chipsalliance/Cores-VeeR-EH2/docs/source/index.md

# {{project}}

```{toctree}
:maxdepth: 2
:numbered:

intro
overview
memory-map
error-protection
multi-threading
timers
power
interrupts
performance
cache
debugging
core-control
adaptations
csrs
interrupt-priority
clocks
complex-ports
build-args
tests
errata
```
