chipsalliance/Cores-VeeR-EH2/(threads)

Thread 10 (2020-10-10):

ICCM Only Mode (How does ICCM talks to External Memory)

HamzaShabbir517, 2020-10-10:
ICCM is in the core complex so in the ICCM Only Mode how are the instruction are loaded into ICCM from the External Memory.
In the test bench there is a task which pre-loads the ICCM, there are few issues with that
1) The first address in the PC is always zero so you never read the instruction from the ICCM.
2) As the address checking range from ICCM always failed so the instruction is always read from the External Memory.
3) Is there is any connectivity between the ICCM and the External Memory to load instruction from External Memory to ICCM?

agrobman, 2020-10-10:
Hi,

1) the ICCM base address is a build parameter and can be set to any value with swerv.config script.
2) CPU reset vector is the CPU complex input and can be driven by an SOC (or Demo TB) to anything. (DemoTB drives it to 0, but this can be easily changed locally if needed)
3) the  ICCM is designed as RAM. it need to be preloaded with application code ( unless redesigned as ROM or flash). Such preload can be done with external master via DMA port, or by the CPU itself if the SOC provides data path from LSU bus to DMA bus. ( One of the provided tests uses the LSU-DMA bridge).
4) ICCM can be preloaded with debugger via abstract memory commands. (via JTAG interface with openOCD driver)
5) Demo TB CCM preload mechanism is artificial and only works with verilog simulators. It is here to speed up simulations and demo purposes. This preloader can't be used with silicon or FPGA.

HamzaShabbir517, 2020-10-11:
As per basic knowledge. If the ICCM is not pre-loaded so during the execution if the instruction is not found so it will read the instruction from the external memory as we do in the cache. As  if there is a miss in cache so than it reads the instruction from memory.
As in Swerv core you have differrnt AXI4 streams for IFU, LSU, DMA and SB so to load instruction into ICCM why the core is using LSU DMA bridge rather than IFU AXI4 stream.

aprnath, 2020-10-11:
The ICCM is not a cache, and does not get loaded on fetch. It is an on-board memory, and only can be loaded via the DMA port, or debugger uploads.
If you set up the ICCM to be located at the reset vector, then you must load the ICCM via the debugger prior to releasing the core from reset. Otherwise the core will spin endlessly on illegal instruction execution fetching uninitialized garbage from the ICCM. I.e - core will not go fetch from external memory if the fetch address falls inside the ICCM region.

In general you need need a mechanism to load programs into the ICCM. Using the DMA port is the only way to do this without involving the debugger. You will need to have an external RAM/ROM that will have the boot-loader code, and either use the DMA port via an external DMA master, or via the bridge. The bridge is a simple filter/redirector/mux for load/stores that match the ICCM address range to reflect back via the DMA port. This allows you to copy programs from external memory into the ICCM. But the copy code itself must be done executing from external memory, or via code in ICCM loaded via the debugger.

Yes, somewhat convoluted :-(

Closed 2020-10-18.

Thread 15 (2021-06-23):

Cores-SweRV-EH2 Lint error

JLstore, 2021-06-23:
I use the **VC static** tools to check the code, and find the following Error.
Code version 1.4

 Tag              : UndrivenInTerm-ML
  Description      : Detected undriven input terminal [DesignObjSignal]
  Violation        : Lint:60
  Goal             : lint_rtl
  Module           : eh2_pic_ctrl
  FileName         : /ip/eh2/eh2_pic_ctrl.sv
  LineNumber       : 654
  Statement        :  assign picm_rd_data_in[31:0] = ({32{intpend_reg_read      }} &   intpend_rd_out                                                    ) |
  DesignObjSignal  : x_ecuss/rvtop/swerv/pic_ctrl_inst/mask[3:0]
  String1          :

 W123  (17 errors/0 waived)
  -----------------------------------------------------------------------------
  Tag           : W123
  Description   : Variable '[VariableName]'[ExprSize] read but never set.[Hierarchy: '[HIERARCHY]']
  Violation     : Lint:760
  Goal          : lint_rtl
  Module        : eh2_ifu_mem_ctl_thr
  FileName      : /ip/eh2/ifu/eh2_ifu_mem_ctl.sv
  LineNumber    : 2111
  Statement     :   assign ic_byp_data_only_pre_new[79:0] =  ({80{~ifu_fetch_addr_int_f2[2] & ~mb_idle}} &   {ic_miss_buff_data[byp_fetch_index_inc_0][15:0],ic_miss_buff_data[byp_fetch_index_1][31:0]     , ic_miss_buff_data[byp_fetch_index_0][31:0]}) |
  VariableName  : byp_fetch_index_inc_1
  ExprSize      :
  HIERARCHY     : rvtop/swerv/ifu/mem_ctl/THREADS[0].ifu_mem_ctl_thr_inst
  -----------------------------------------------------------------------------
  Tag           : W123
  Description   : Variable '[VariableName]'[ExprSize] read but never set.[Hierarchy: '[HIERARCHY]']
  Violation     : Lint:759
  Goal          : lint_rtl
  Module        : eh2_ifu_mem_ctl_thr
  FileName      : /ip/eh2/ifu/eh2_ifu_mem_ctl.sv
  LineNumber    : 2111
  Statement     :   assign ic_byp_data_only_pre_new[79:0] =  ({80{~ifu_fetch_addr_int_f2[2] & ~mb_idle}} &   {ic_miss_buff_data[byp_fetch_index_inc_0][15:0],ic_miss_buff_data[byp_fetch_index_1][31:0]     , ic_miss_buff_data[byp_fetch_index_0][31:0]}) |
  VariableName  : byp_fetch_index_inc_0
  ExprSize      :
  HIERARCHY     : rvtop/swerv/ifu/mem_ctl/THREADS[0].ifu_mem_ctl_thr_inst
  -----------------------------------------------------------------------------
  Tag           : W123
  Description   : Variable '[VariableName]'[ExprSize] read but never set.[Hierarchy: '[HIERARCHY]']
  Violation     : Lint:667
  Goal          : lint_rtl
  Module        : eh2_ifu_bp_ctl
  FileName      : /ip/eh2/ifu/eh2_ifu_bp_ctl.sv
  LineNumber    : 1710
  Statement     :         wire[3:0] wr_sel = {
  VariableName  : bht_wr_addr1
  ExprSize      :
  HIERARCHY     : rvtop/swerv/ifu/bp
  -----------------------------------------------------------------------------
  Tag           : W123
  Description   : Variable '[VariableName]'[ExprSize] read but never set.[Hierarchy: '[HIERARCHY]']
  Violation     : Lint:757
  Goal          : lint_rtl
  Module        : eh2_ifu_mem_ctl_thr
  FileName      : /ip/eh2/ifu/eh2_ifu_mem_ctl.sv
  LineNumber    : 2111
  Statement     :   assign ic_byp_data_only_pre_new[79:0] =  ({80{~ifu_fetch_addr_int_f2[2] & ~mb_idle}} &   {ic_miss_buff_data[byp_fetch_index_inc_0][15:0],ic_miss_buff_data[byp_fetch_index_1][31:0]     , ic_miss_buff_data[byp_fetch_index_0][31:0]}) |
  VariableName  : byp_fetch_index_0
  ExprSize      :
  HIERARCHY     : rvtop/swerv/ifu/mem_ctl/THREADS[0].ifu_mem_ctl_thr_inst
  -----------------------------------------------------------------------------
  Tag           : W123
  Description   : Variable '[VariableName]'[ExprSize] read but never set.[Hierarchy: '[HIERARCHY]']
  Violation     : Lint:669
  Goal          : lint_rtl
  Module        : eh2_ifu_bp_ctl
  FileName      : /ip/eh2/ifu/eh2_ifu_bp_ctl.sv
  LineNumber    : 1710
  Statement     :         wire[3:0] wr_sel = {
  VariableName  : bht_wr_addr3
  ExprSize      :
  HIERARCHY     : rvtop/swerv/ifu/bp
  -----------------------------------------------------------------------------
  Tag           : W123
  Description   : Variable '[VariableName]'[ExprSize] read but never set.[Hierarchy: '[HIERARCHY]']
  Violation     : Lint:658
  Goal          : lint_rtl
  Module        : eh2_ifu
  FileName      : /ip/eh2/ifu/eh2_ifu.sv
  LineNumber    : 590
  Statement     :       assign ifu_i1_bp_index [pt.NUM_THREADS-1:0] =  i1_bp_index[pt.NUM_THREADS-1:0];
  VariableName  : i1_bp_index
  ExprSize      : (1 bits)
  HIERARCHY     : rvtop/swerv/ifu
  -----------------------------------------------------------------------------
  Tag           : W123
  Description   : Variable '[VariableName]'[ExprSize] read but never set.[Hierarchy: '[HIERARCHY]']
  Violation     : Lint:660
  Goal          : lint_rtl
  Module        : eh2_ifu
  FileName      : /ip/eh2/ifu/eh2_ifu.sv
  LineNumber    : 586
  Statement     :       assign ifu_i0_bp_index [pt.NUM_THREADS-1:0] =  i0_bp_index[pt.NUM_THREADS-1:0];
  VariableName  : i0_bp_index
  ExprSize      : (1 bits)
  HIERARCHY     : rvtop/swerv/ifu
  -----------------------------------------------------------------------------
  Tag           : W123
  Description   : Variable '[VariableName]'[ExprSize] read but never set.[Hierarchy: '[HIERARCHY]']
  Violation     : Lint:1016
  Goal          : lint_rtl
  Module        : eh2_dec_csr
  FileName      : /ip/eh2/dec/eh2_dec_csr.sv
  LineNumber    : 607
  Statement     :    assign tlu_csr_pkt_d.valid_only = valid_only;
  VariableName  : valid_only
  ExprSize      :
  HIERARCHY     : rvtop/swerv/dec/tlu/i0_csr_decoder
  -----------------------------------------------------------------------------
  Tag           : W123
  Description   : Variable '[VariableName]'[ExprSize] read but never set.[Hierarchy: '[HIERARCHY]']
  Violation     : Lint:2017
  Goal          : lint_rtl
  Module        : eh2_pic_ctrl
  FileName      : /ip/eh2/eh2_pic_ctrl.sv
  LineNumber    : 654
  Statement     :  assign picm_rd_data_in[31:0] = ({32{intpend_reg_read      }} &   intpend_rd_out                                                    ) |
  VariableName  : mask[3:0]
  ExprSize      :
  HIERARCHY     : rvtop/swerv/pic_ctrl_inst
  -----------------------------------------------------------------------------
  Tag           : W123
  Description   : Variable '[VariableName]'[ExprSize] read but never set.[Hierarchy: '[HIERARCHY]']
  Violation     : Lint:779
  Goal          : lint_rtl
  Module        : eh2_ifu_aln_ctl
  FileName      : /ip/eh2/ifu/eh2_ifu_aln_ctl.sv
  LineNumber    : 1061
  Statement     :    assign i1_bp_index[pt.BTB_ADDR_HI:pt.BTB_ADDR_LO] = (i1_shift) ? i1_bpindex : '0;
  VariableName  : i1_bpindex
  ExprSize      :
  HIERARCHY     : rvtop/swerv/ifu/aln[0].aln
  -----------------------------------------------------------------------------
  Tag           : W123
  Description   : Variable '[VariableName]'[ExprSize] read but never set.[Hierarchy: '[HIERARCHY]']
  Violation     : Lint:778
  Goal          : lint_rtl
  Module        : eh2_ifu_aln_ctl
  FileName      : /ip/eh2/ifu/eh2_ifu_aln_ctl.sv
  LineNumber    : 1056
  Statement     :    assign i0_bp_index[pt.BTB_ADDR_HI:pt.BTB_ADDR_LO] = (i0_shift) ? i0_bpindex : '0;
  VariableName  : i0_bpindex
  ExprSize      :
  HIERARCHY     : rvtop/swerv/ifu/aln[0].aln
  -----------------------------------------------------------------------------
  Tag           : W123
  Description   : Variable '[VariableName]'[ExprSize] read but never set.[Hierarchy: '[HIERARCHY]']
  Violation     : Lint:2166
  Goal          : lint_rtl
  Module        : eh2_ifu_iccm_mem
  FileName      : /ip/eh2/ifu/eh2_ifu_iccm_mem.sv
  LineNumber    : 667
  Statement     :    assign iccm_rd_data_pre[95:0] = {iccm_bank_dout_fn[iccm_rd_addr_hi_q][31:0], iccm_bank_dout_fn[iccm_rd_addr_md_q][31:0], iccm_bank_dout_fn[iccm_rd_addr_lo_q[pt.ICCM_BANK_HI:2]][31:0]};
  VariableName  : iccm_rd_addr_md_q
  ExprSize      :
  HIERARCHY     : rvtop/mem/iccm.iccm
  -----------------------------------------------------------------------------
  Tag           : W123
  Description   : Variable '[VariableName]'[ExprSize] read but never set.[Hierarchy: '[HIERARCHY]']
  Violation     : Lint:668
  Goal          : lint_rtl
  Module        : eh2_ifu_bp_ctl
  FileName      : /ip/eh2/ifu/eh2_ifu_bp_ctl.sv
  LineNumber    : 1710
  Statement     :         wire[3:0] wr_sel = {
  VariableName  : bht_wr_addr2
  ExprSize      :
  HIERARCHY     : rvtop/swerv/ifu/bp
  -----------------------------------------------------------------------------
  Tag           : W123
  Description   : Variable '[VariableName]'[ExprSize] read but never set.[Hierarchy: '[HIERARCHY]']
  Violation     : Lint:666
  Goal          : lint_rtl
  Module        : eh2_ifu_bp_ctl
  FileName      : /ip/eh2/ifu/eh2_ifu_bp_ctl.sv
  LineNumber    : 1710
  Statement     :         wire[3:0] wr_sel = {
  VariableName  : bht_wr_addr0
  ExprSize      :
  HIERARCHY     : rvtop/swerv/ifu/bp
  -----------------------------------------------------------------------------
  Tag           : W123
  Description   : Variable '[VariableName]'[ExprSize] read but never set.[Hierarchy: '[HIERARCHY]']
  Violation     : Lint:2077
  Goal          : lint_rtl
  Module        : EH2_IC_TAG
  FileName      : /ip/eh2/ifu/eh2_ifu_ic_mem.sv
  LineNumber    : 1373
  Statement     :                  `EH2_IC_TAG_PACKED_SRAM(64,104)
  VariableName  : ic_rw_addr_q
  ExprSize      :
  HIERARCHY     : rvtop/mem/icache.icm/ic_tag_inst
  -----------------------------------------------------------------------------
  Tag           : W123
  Description   : Variable '[VariableName]'[ExprSize] read but never set.[Hierarchy: '[HIERARCHY]']
  Violation     : Lint:2165
  Goal          : lint_rtl
  Module        : eh2_ifu_iccm_mem
  FileName      : /ip/eh2/ifu/eh2_ifu_iccm_mem.sv
  LineNumber    : 667
  Statement     :    assign iccm_rd_data_pre[95:0] = {iccm_bank_dout_fn[iccm_rd_addr_hi_q][31:0], iccm_bank_dout_fn[iccm_rd_addr_md_q][31:0], iccm_bank_dout_fn[iccm_rd_addr_lo_q[pt.ICCM_BANK_HI:2]][31:0]};
  VariableName  : iccm_rd_addr_hi_q
  ExprSize      :
  HIERARCHY     : rvtop/mem/iccm.iccm
  -----------------------------------------------------------------------------
  Tag           : W123
  Description   : Variable '[VariableName]'[ExprSize] read but never set.[Hierarchy: '[HIERARCHY]']
  Violation     : Lint:758
  Goal          : lint_rtl
  Module        : eh2_ifu_mem_ctl_thr
  FileName      : /ip/eh2/ifu/eh2_ifu_mem_ctl.sv
  LineNumber    : 2111
  Statement     :   assign ic_byp_data_only_pre_new[79:0] =  ({80{~ifu_fetch_addr_int_f2[2] & ~mb_idle}} &   {ic_miss_buff_data[byp_fetch_index_inc_0][15:0],ic_miss_buff_data[byp_fetch_index_1][31:0]     , ic_miss_buff_data[byp_fetch_index_0][31:0]}) |
  VariableName  : byp_fetch_index_1
  ExprSize      :
  HIERARCHY     : rvtop/swerv/ifu/mem_ctl/THREADS[0].ifu_mem_ctl_thr_inst

agrobman, 2021-06-23:
Based on designers response, these warnings are "bogus".  We have no idea what this lint tool is. Please, consult with the tool vendor why the tool flags these structures.

JLstore, 2021-06-24:
@agrobman
The above report is errors not warnings.
 For example , I check that the _**mask**_ signal in the /ip/eh2/eh2_pic_ctrl.sv is not drived.
 I guss the errors labeled "Description : Variable '[VariableName]'[ExprSize] read but never set.[Hierarchy: '[HIERARCHY]']"  are the same reason.
Because I find the _**valid_only**_ signal in the dec/eh2_dec_csr.sv is not drived, either.
Please designers check the above errors again.
About the lint tool. https://www.synopsys.com/verification/static-and-formal-verification/vc-formal.html

agrobman, 2021-06-24:
the mask signal is driven in pic_map_auto.h (generated) file.

valid_only is not used ...

JLstore, 2021-06-25:
@agrobman
The pic_map_auto.h is empty. What do I miss in the configuration(swerv.config file)
valid_only is not used, which means that the following signals belong to **the above log** are not used or driven in pic_map_auto.h?
Signal:
byp_fetch_index_inc_1
bht_wr_addr1
bht_wr_addr3
byp_fetch_index_inc_0
bht_wr_addr2
byp_fetch_index_0
i1_bp_index
i0_bp_index
i1_bpindex
bht_wr_addr0
i0_bpindex
iccm_rd_addr_md_q
ic_rw_addr_q
iccm_rd_addr_hi_q
byp_fetch_index_1

agrobman, 2021-06-25:
just ran
make -f $RV_ROOT/tools/Makefile
snanpshots/default/pic_map_auto.h :

```
// mask[3:0] = { 4'b1000 - 30b mask,4'b0100 - 31b mask, 4'b0010 - 28b mask, 4'b0001 - 32b mask }
always_comb begin
  case (address[14:0])
    15'b011000000000000 : mask[3:0] = 4'b0100;
    15'b110000000000100 : mask[3:0] = 4'b0001;
    15'b110000000001000 : mask[3:0] = 4'b0001;
    15'b110000000001100 : mask[3:0] = 4'b0001;
    15'b110000000010000 : mask[3:0] = 4'b0001;
    15'b110000000010100 : mask[3:0] = 4'b0001;
    15'b110000000011000 : mask[3:0] = 4'b0001;
    15'b110000000011100 : mask[3:0] = 4'b0001;
...
    15'b000000111111100 : mask[3:0] = 4'b0010;
    default           : mask[3:0] = 4'b0001;
  endcase
end

```
try to see if you can run:
`$RV_ROOT/tools/picmap -t 20 -n 1`

for ic_rw_addr_q  :

```
grep -r ic_rw_addr_q design
design/ifu/eh2_ifu_ic_mem.sv:   logic [pt.ICACHE_INDEX_HI:1]                                                   ic_rw_addr_q;
..
design/ifu/eh2_ifu_ic_mem.sv:  assign ic_rw_addr_q[pt.ICACHE_INDEX_HI:1] = (ic_debug_rd_en | ic_debug_wr_en) ?
```

```
i1_bp_index
design/ifu/eh2_ifu_aln_ctl.sv:   output logic [pt.BTB_ADDR_HI:pt.BTB_ADDR_LO]  i1_bp_index,  // BP index
design/ifu/eh2_ifu_aln_ctl.sv:   assign i1_bp_index[pt.BTB_ADDR_HI:pt.BTB_ADDR_LO] = (i1_shift) ? i1_bpindex : '0;
```

JLstore, 2021-06-28:
@agrobman
Thanks !
I just run

_make -f $RV_ROOT/tools/Makefile
$RV_ROOT/tools/picmap -t 20 -n 1
./swerv.config ..._

then I get my configurtion with mask signal (in pic_map_auto.h ).

About ic_rw_addr_q, i1_bp_index ... signals and so on.
I can grep them in the design, also.
I mean  how I can handle these lint error ?  Can I just ignore them ?

JLstore, 2021-06-29:
@agrobman
I check the following signals, find those signals are not defined from 0 bit, which I guss the lint tools regard them as error.
Thank for your help.

Signal:
byp_fetch_index_inc_1
bht_wr_addr1
bht_wr_addr3
byp_fetch_index_inc_0
bht_wr_addr2
byp_fetch_index_0
i1_bp_index
i0_bp_index
i1_bpindex
bht_wr_addr0
i0_bpindex
iccm_rd_addr_md_q
ic_rw_addr_q
iccm_rd_addr_hi_q
byp_fetch_index_1

Closed 2021-06-29.

Thread 18 (2021-07-22):

Core Design validation/verification

SyoAnd, 2021-07-22:
Hello
I see in the documentation that this core has been validated to compliance with RISC-V spec.
But it is not stated to what level the core is checked.
Is it a simple compliance check, validation, or a full verification?

I want to make an addition to the core, but in doing so, I want to make sure that I don't break the execution of the core in any way.
How would I do this the best way?
I have looked at several tools for validation, RISCOF being the latest one. Will I be able to use it for validation of this design?

aprnath, 2021-07-22:
Hi @SyoAnd,

It is full verification, per the spec.

However, this verification environment is not currently part of this opensource effort. So you would need to first plan, build and execute a full verification suite, in case you wish to make changes/additions :-( .
Or you could possibly use some incremental equivalency checking mechanisms to incrementally check your localized changes.

Thread 19 (2021-09-08):

multi thread cache miss question

S-Nomii, 2021-09-08:
Hi, I am studying how EH2 handle cache miss, and i encountered a problem about the miss state machine. How does the DUPL_MISS_WAIT state work?

What I currently understand is :
When thread 1 miss on an index on which thread 0 is currently handling an elder miss, thread 1 use this state to lock its miss handler. Thread 1 will release the lock, refetch the missing line and start handling this latter miss after thread 0 is done.

 I dont know if I understand this state correctly. If I'm right, what is the purpose of this processing sequence? Is it for LRU update order.

iknowzxc, 2023-03-17:
maybe MSHR, DUPL is duplicated

Thread 20 (2021-09-21):

understanding I-Cache

vignajeth, 2021-09-21:
Hi,
  I am trying to understand the RTL that generates the I-Cache. I am currently running the default configuration that makes the core run on single thread.
I find the parameters in eh2_param.vh as
```
ICACHE_BANKS_WAY       : 7'h02
ICACHE_NUM_WAYS        : 7'h04
```
based on this I am interpreting it as two-way set associative cache as BANKS means Blocks and NUM_WAYS means Number_of_Sets in a cache
I am focusing only on the Packed I-Cache and ECC enabled, However I am confused with this line of code
https://github.com/chipsalliance/Cores-SweRV-EH2/blob/a95fdb81ea6dc19239cfe2953ef00710a6f1cf2a/design/ifu/eh2_ifu_ic_mem.sv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
because the cache data should be only in one of the bank, but here I find both the banks data merged into a array and is later used

please let me know if my understanding is wrong or if you need few more details about my doubt

agrobman, 2021-09-21:
ICACHE_NUM_WAYS - defines cache associativity , meaning in your case the cache has 4 ways.
BANKS_WAY - number data memory arrays per way, i.e. 2 - it's fixed design parameter, which can't be changed without RTL changes

vignajeth, 2021-09-22:
Okay, This means there is only 1 Set in I-Cache no matter the size of I-cache or whether it is two or four way associative, right ?

agrobman, 2021-09-22:
depends on what do you call 'Set'

Closed 2021-09-27.

Thread 23 (2021-10-05):

Working of Non-Blocking Loads

vignajeth, 2021-10-05:
Hi,
    When I run hello world assembly code, I notice that STDOUT data moves out of LSU through non-blocking loads.

I would like to know how the core decides that it can move the data through non-blocking load ports

I was unable to get much information about non-blocking loads from PRM, the PRM I think just has registers that can point out during non-blocking load bus errors.

```
        79 :      #20 0 00000042 00010217  tp=00010042 ; auipc   tp,0x10000
        80 :      #21 0 00000046 fbe20213  tp=00010000 ; addi    tp,tp,-66
        80 :      #22 0 0000004a 0000a821              ; c.j     0x62
        85 :      #23 0 00000062 00020283              ; lb      t0,0(tp) [00010000]
        87 :          0                    t0=0000002d ; nbL       <--------------------------------- Here
        93 :      #24 0 00000066 00518023              ; sb      t0,0(gp) [d0580000]
        93 :      #25 0 0000006a 00000205  tp=00010001 ; c.addi  tp,1
        94 :      #26 0 0000006c fe029be3              ; bne     t0,zero,0x62
        99 :      #27 0 00000062 00020283              ; lb      t0,0(tp) [00010001]
       101 :          0                    t0=0000002d ; nbL       <--------------------------------- Here
       107 :      #28 0 00000066 00518023              ; sb      t0,0(gp) [d0580000]
```

Thanks

aprnath, 2021-10-05:
Non-blocking loads are a micro-architectural feature for performance improvement. They are not SW or architecturally visible, hence not mentioned in detail in the Programmer's reference Manual.

All loads to external memory are treated as non-blocking. The core issues and commits them without waiting for data to be returned. However, it keeps track of register dependencies, and blocks subsequent instruction that consume the data from the load's destination register from being issued into the pipe until dependent loads return data. This allows a certain small "out-of-order"ness to the core to give a performance boost.

Closed 2021-12-09.

Thread 25 (2021-10-21):

understanding store_databypass_c1 and c2

vignajeth, 2021-10-21:
Hi,
   I am trying to understand how _store_data_bypass_c1_ and _store_data_bypass_c2_ signal helps in forwarding data.
I took a simple RAW hazard scenario as below and only one thread is executing this in order.
```
  lw X13, 23(X10);
  sw X13, 32(X11);
```
when the `sw` instruction is in decode stage the _store_data_bypass_c2_ should become high.
the LSU dc1 to dc3 stages for the two instruction should be like
```
LW LW LW
   SW SW
```
and from the code of lsu I can understand that when `sw` instruction is executed in lsu,  _store_data_dc2_ gets overwritten with _lsu_result_dc3_ data. which is basically forwarding `lw` data

but this is a best case scenario since the previous `lw` instruction should have obtained data in dc3 either through lsu_buffer or from a forwarding logic.

My question here is if the previous `lw`  data was not in buffer, it should take 5 or 6 CC to get data from the main memory, then this `sw` instruction should be stalled for few cycles, but i don't think this stall happens or there is some other way the core takes care of this situation.

it would be great if someone can help me fill my missing piece of insight.

vignajeth, 2021-11-05:
```  assign i1_load2_block_d = i1_dp.lsu & i0_dp.lsu;```
 👍

Closed 2021-11-05.

Thread 31 (2021-12-09):

understanding of axi_lsu_dma_bridge

vignajeth, 2021-12-09:
Hi,
   I notice that the module `axi_lsu_dma_bridge`  in testbench has one master (lsu) and two slaves ( s0 - main memory, s1 - dma).
   When I looked into the code I observed that when the master provided address falls into iccm address range,  the bridge directs the request to dma slave.

right now the TB directly dumps the data into dccm, iccm. but in real case scenario with the use of lw, sw instructions pointing to dccm address it is possible to write/read data from dccm.

However, to write data into iccm, the data should be moved through lsu and is written in iccm through dma using this bridge right ?
in case of read to iccm, the lsu read request is sent to dma slave , the dma slave will fetch data from iccm and give it to lsu right ?

In short, can i say that this bridge is used for reading/writing iccm ?

let me know if my understanding is write / wrong 😃

aprnath, 2021-12-09:
Yes, your understanding is correct. This bridge is an external splitter component that helps provide a loopback path to do load/stores to the ICCM via the DMA port. The ICCM would otherwise not be accessible other than via debugger or needing an external DMA master in the SOC.

vignajeth, 2021-12-10:
Thanks for your reply

Closed 2021-12-10.

Thread 32 (2021-12-13):

No improvement for Statistics

samfishman1, 2021-12-13:
Hi, I am currently trying to improve upon the base statistics generated when running the Coremark example.
I am running with the following command
` make -f $RV_ROOT/tools/Makefile $@ target=default TEST=cmark'

Where the $@ is a number of CONF_PARAM=-set=... commands that I have being set from another file. These params include changing the icache_size and dccm_size, basically all variables provided in order to try to change the coremark return values at all. So far though it seems as if there has been no change at all, is there another step that I am missing? I have not installed espresso, is this necessary?

vignajeth, 2021-12-14:
Hi,
    I notice a typo, it is CONF_PARAMS and this is the exact command i used in command line
     `make -f ./tools/Makefile clean irun debug=1 TEST=hello_world CONF_PARAMS=-set=build_axi4\ -set=load_to_use_plus1=1`
    I was able to see `LOAD_TO_USE_PLUS1      : 5'h01 ` which is 0 by default. So, i think there is some mistake in your Makefile.

samfishman1, 2021-12-14:
Hi,
I think I may have been unclear, the CONF_PARAMS is not the issue I am having. I am able to pass these values and they are set with the command line with no issue. The problem happens after the params have been set. When the test runs we see an output for it such as this:

> 2K performance run parameters for coremark.
CoreMark Size    : 666
Total ticks      : 457594
Total time (secs): 457
Iterat/Sec/MHz   : 2.18
Iterations       : 1
Compiler version : GCC11.1.0
Compiler flags   : -g -O3 -funroll-all-loops
Memory location  : STATIC
seedcrc          : 0xe9f5
[0]crclist       : 0xe714
[0]crcmatrix     : 0x1fd7
[0]crcstate      : 0x8e3a
[0]crcfinal      : 0xe714
Correct operation validated. See readme.txt for run and reporting rules.
TEST_PASSED
Finished hart0 : minstret = 300365, mcycle = 481320

And when I insert new CONF_PARAMS I would expect values such as minstret and mcycle to chane. BUT the issue I am having is that when I change the CONF_PARAMS there is no change in the output statistics between test runs.

I am deleting the program.hex between runs and the test is recompiling each time. Is there possibly another step or another link I have to set in order to force the tests statistics to change due to the CONF_PARAMS?

vignajeth, 2021-12-15:
What parameter you change matters. if you try comparing the cmark results with two different DCCM sizes, you will find that both of them give same values. This is because cmark does not use DCCM.

do you get the same results with the commands as below ?

Command: make -f ./tools/Makefile clean irun debug=1 TEST=cmark CONF_PARAMS=-set=build_axi4\ -set=lsu_stbuf_depth=8\ -set=lsu_num_nbload=8
>2K performance run parameters for coremark.
CoreMark Size    : 666
Total ticks      : 453314
Total time (secs): 453
Iterat/Sec/MHz   : 2.20
Iterations       : 1
Compiler version : GCC8.3.0
Compiler flags   : -g -O3 -funroll-all-loops
Memory location  : STATIC
seedcrc          : 0xe9f5
[0]crclist       : 0xe714
[0]crcmatrix     : 0x1fd7
[0]crcstate      : 0x8e3a
[0]crcfinal      : 0xe714
Correct operation validated. See readme.txt for run and reporting rules.
TEST_PASSED
Finished hart0 : minstret = 298128, mcycle = 478988

Command: make -f ./tools/Makefile clean irun debug=1 TEST=cmark CONF_PARAMS=-set=build_axi4\ -set=lsu_stbuf_depth=2\ -set=lsu_num_nbload=2
> 2K performance run parameters for coremark.
CoreMark Size    : 666
Total ticks      : 972823
Total time (secs): 972
Iterat/Sec/MHz   : 1.02
Iterations       : 1
Compiler version : GCC8.3.0
Compiler flags   : -g -O3 -funroll-all-loops
Memory location  : STATIC
seedcrc          : 0xe9f5
[0]crclist       : 0xe714
[0]crcmatrix     : 0x1fd7
[0]crcstate      : 0x8e3a
[0]crcfinal      : 0xe714
Correct operation validated. See readme.txt for run and reporting rules.
TEST_PASSED
Finished hart0 : minstret = 298123, mcycle = 1043357

samfishman1, 2021-12-15:
With these exact commands I am unable to run. I am unsure where the library for irun is, but I have been unable to find online where to download/how to install it so I had to remove this command. As well when I include the clean command in this the test is never executed, instead the directory is just cleaned of the previous test and then the run stops.
Even after removing these two commands I still am experiencing an error due to the lsu_stbuf flag due to a comparison error in the verilator.
Are there any packages you would recommend installing?
What environment are you running in? I am running on ubuntu20.04 on a bare metal/equinix c1.small.x86 remote server
Thank you!

agrobman, 2021-12-15:
use 'verilator' instead of 'irun' with make command or whatever system verilog  simulator you have of the supported by the project makefile (vcs, vlog etc)  (read README.md first, how to run simulations with this core)

Thread 33 (2021-12-19):

[Question] AXI4-ectomy

michael-etzkorn, 2021-12-19:
If I wanted to try removing the AXI4 bus interface and replace it with a different bus interface, would modifying `eh2_ifu_mem_ctl` and `eh2_lsu_bus_intf` be sufficient? I'm still tracing the code where `.*` is used, but I figure it should be possible to swap the cache's memory interface.

aprnath, 2022-01-04:
Yes, these are good places to start for the fetch and load/store bus. However, you will also need to touch  eh2_dma_ctrl.sv and eh2_dbg.sv for the DMA and debug bus interfaces.

michael-etzkorn, 2022-01-05:
Great! Appreciate the guidance 😄

Closed 2022-01-05.

Thread 39 (2022-07-06):

PreSync/PostSync in CSR Registers

vignajeth, 2022-07-06:
Hi,
   Can someone tell the difference between presync/postsync in CSR registers ? .  why such synchronization is required ?. At a very high level,  I can see these pre/post sync introduce stalls in pipe and the stall remains active until the pipeline is empty. But I can't figure out the difference between the them.

Thanks

Thread 40 (2023-02-07):

Repeated entry interrupt

luis-han255, 2023-02-07:
Hi，
When I trigger PIC interrupt，the value of **mcause** register is **0x2** and **mepc** register is **0x0**. I found that the general register **x1** has return address and then assigned it to mepc. Sometimes interruptions can end smoothly, Sometimes after exiting interrupt, it will enter the interrupt handler again, and x1 is 0. Of course, I have cleared the interrupt source.
Please give me some suggestions on this issue.

Thanks

Thread 42 (2024-06-05):

dhry_mt benchmark failed

chchenl, 2024-06-05:
Hi all,
I cannot successfully run dhry_mt program-- it always times out. But if I remark the last few 'printf' related to
floating point calculations(on performance numbers), the progarm can be successfully completed. But strange
enough, the cmark program can be successfully completed in spite of its having floating point calculations.

Does anyone have any ideas on this? My enviroment is : verilator 4.227, riscv toolchain compiled based on gcc 10.2.0
The command issued is: make -f $RV_ROOT/tools/Makefile verilator target=default_mt TEST=dhry_mt
