chipsalliance/Cores-VeeR-EH2/testbench/tb_top.sv

// SPDX-License-Identifier: Apache-2.0
// Copyright 2019,2020 Western Digital Corporation or its affiliates.
//
// Licensed under the Apache License, Version 2.0 (the "License");
// you may not use this file except in compliance with the License.
// You may obtain a copy of the License at
//
// http://www.apache.org/licenses/LICENSE-2.0
//
// Unless required by applicable law or agreed to in writing, software
// distributed under the License is distributed on an "AS IS" BASIS,
// WITHOUT WARRANTIES OR CONDITIONS OF ANY KIND, either express or implied.
// See the License for the specific language governing permissions and
// limitations under the License.
//
// this is testbench file

`ifdef VERILATOR
module tb_top (
    input bit                   core_clk,
    input bit [31:0]            mem_signature_begin,
    input bit [31:0]            mem_signature_end
);
`else
module tb_top;
    bit                         core_clk;
`endif
    logic                       rst_l;
    logic                       porst_l;
    logic                       nmi_int;

`ifndef VERILATOR
    bit          [31:0]         mem_signature_begin = 32'd0;
    bit          [31:0]         mem_signature_end   = 32'd0;
`endif

    logic        [`RV_XLEN-1:0] reset_vector;
    logic        [`RV_XLEN-1:0] nmi_vector;
    logic        [31:1]         jtag_id;

// AHB
    logic        [`RV_XLEN-1:0]         ic_haddr;
    logic        [2:0]                  ic_hburst;
    logic        [3:0]                  ic_hprot;
    logic        [2:0]                  ic_hsize;
    logic        [1:0]                  ic_htrans;
    logic                               ic_hwrite;
    logic        [`RV_BUS_WIDTH-1:0]    ic_hrdata;
    logic                               ic_hready;
    logic                               ic_hresp;

    logic        [`RV_XLEN-1:0]         lsu_haddr;
    logic        [2:0]                  lsu_hburst;
    logic        [3:0]                  lsu_hprot;
    logic        [2:0]                  lsu_hsize;
    logic        [1:0]                  lsu_htrans;
    logic                               lsu_hwrite;
    logic        [`RV_BUS_WIDTH-1:0]    lsu_hrdata;
    logic        [`RV_BUS_WIDTH-1:0]    lsu_hwdata;
    logic                               lsu_hready;
    logic                               lsu_hresp;

    logic [`RV_NUM_THREADS-1:0][`RV_XLEN*2-1:0] trace_rv_i_insn_ip;
    logic [`RV_NUM_THREADS-1:0][`RV_XLEN*2-1:0] trace_rv_i_address_ip;
    logic [`RV_NUM_THREADS-1:0][1:0]           trace_rv_i_valid_ip;
    logic [`RV_NUM_THREADS-1:0][1:0]           trace_rv_i_exception_ip;
    logic [`RV_NUM_THREADS-1:0][4:0]           trace_rv_i_ecause_ip;
    logic [`RV_NUM_THREADS-1:0][1:0]           trace_rv_i_interrupt_ip;
    logic [`RV_NUM_THREADS-1:0][`RV_XLEN*2-1:0] trace_rv_i_tval_ip;

    logic                       o_debug_mode_status;


    logic                       jtag_tdo;
    logic                       o_cpu_halt_ack;
    logic                       o_cpu_halt_status;
    logic                       o_cpu_run_ack;

    logic                       mailbox_write;

    logic [`RV_BUS_WIDTH-1:0]   lmem_hrdata;
    logic [`RV_BUS_WIDTH-1:0]   lmem_hwdata;
    logic                       lmem_hready;
    logic                       lmem_hresp;
    logic [`RV_XLEN-1:0]        lmem_haddr;
    logic [2:0]                 lmem_hburst;
    logic                       lmem_hmastlock;
    logic [3:0]                 lmem_hprot;
    logic [2:0]                 lmem_hsize;
    logic [1:0]                 lmem_htrans;
    logic                       lmem_hwrite;
    logic                       lmem_hsel;

    logic [`RV_BUS_WIDTH-1:0]   dma_hrdata;
    logic [`RV_BUS_WIDTH-1:0]   dma_hwdata;
    logic                       dma_hready;
    logic                       dma_hresp;
    logic [`RV_XLEN-1:0]        dma_haddr;
    logic [2:0]                 dma_hburst;
    logic                       dma_hmastlock;
    logic [3:0]                 dma_hprot;
    logic [2:0]                 dma_hsize;
    logic [1:0]                 dma_htrans;
    logic                       dma_hwrite;
    logic                       dma_hsel;

    logic                       mpc_debug_halt_req;
    logic                       mpc_debug_run_req;
    logic                       mpc_reset_run_req;
    logic                       mpc_debug_halt_ack;
    logic                       mpc_debug_run_ack;
    logic                       debug_brkpt_status;

    bit        [31:0]           cycleCnt;
    logic                       mailbox_data_val;

    int                         commit_count[2];

    logic [1:0]                 wb_valid;
    logic [1:0][4:0]            wb_dest;
    logic [1:0][`RV_XLEN-1:0]   wb_data;
    logic [1:0]                 wb_tid;

   //-------------------------- LSU AXI signals--------------------------
   // AXI Write Channels
    wire                            lsu_axi_awvalid;
    wire                            lsu_axi_awready;
    wire [`RV_LSU_BUS_TAG-1:0]      lsu_axi_awid;
    wire [`RV_XLEN-1:0]             lsu_axi_awaddr;
    wire [3:0]                      lsu_axi_awregion;
    wire [7:0]                      lsu_axi_awlen;
    wire [2:0]                      lsu_axi_awsize;
    wire [1:0]                      lsu_axi_awburst;
    wire                            lsu_axi_awlock;
    wire [3:0]                      lsu_axi_awcache;
    wire [2:0]                      lsu_axi_awprot;
    wire [3:0]                      lsu_axi_awqos;

    wire                            lsu_axi_wvalid;
    wire                            lsu_axi_wready;
    wire [`RV_BUS_WIDTH-1:0]        lsu_axi_wdata;
    wire [`RV_BUS_BYTES-1:0]        lsu_axi_wstrb;
    wire                            lsu_axi_wlast;

    wire                            lsu_axi_bvalid;
    wire                            lsu_axi_bready;
    wire [1:0]                      lsu_axi_bresp;
    wire [`RV_LSU_BUS_TAG-1:0]      lsu_axi_bid;

    // AXI Read Channels
    wire                            lsu_axi_arvalid;
    wire                            lsu_axi_arready;
    wire [`RV_LSU_BUS_TAG-1:0]      lsu_axi_arid;
    wire [`RV_XLEN-1:0]             lsu_axi_araddr;
    wire [3:0]                      lsu_axi_arregion;
    wire [7:0]                      lsu_axi_arlen;
    wire [2:0]                      lsu_axi_arsize;
    wire [1:0]                      lsu_axi_arburst;
    wire                            lsu_axi_arlock;
    wire [3:0]                      lsu_axi_arcache;
    wire [2:0]                      lsu_axi_arprot;
    wire [3:0]                      lsu_axi_arqos;

    wire                            lsu_axi_rvalid;
    wire                            lsu_axi_rready;
    wire [`RV_LSU_BUS_TAG-1:0]      lsu_axi_rid;
    wire [`RV_BUS_WIDTH-1:0]        lsu_axi_rdata;
    wire [1:0]                      lsu_axi_rresp;
    wire                            lsu_axi_rlast;

    //-------------------------- IFU AXI signals--------------------------
    // AXI Write Channels
    wire                            ifu_axi_awvalid;
    wire                            ifu_axi_awready;
    wire [`RV_IFU_BUS_TAG-1:0]      ifu_axi_awid;
    wire [`RV_XLEN-1:0]             ifu_axi_awaddr;
    wire [3:0]                      ifu_axi_awregion;
    wire [7:0]                      ifu_axi_awlen;
    wire [2:0]                      ifu_axi_awsize;
    wire [1:0]                      ifu_axi_awburst;
    wire                            ifu_axi_awlock;
    wire [3:0]                      ifu_axi_awcache;
    wire [2:0]                      ifu_axi_awprot;
    wire [3:0]                      ifu_axi_awqos;

    wire                            ifu_axi_wvalid;
    wire                            ifu_axi_wready;
    wire [63:0]                     ifu_axi_wdata;
    wire [7:0]                      ifu_axi_wstrb;
    wire                            ifu_axi_wlast;

    wire                            ifu_axi_bvalid;
    wire                            ifu_axi_bready;
    wire [1:0]                      ifu_axi_bresp;
    wire [`RV_IFU_BUS_TAG-1:0]      ifu_axi_bid;

    // AXI Read Channels
    wire                            ifu_axi_arvalid;
    wire                            ifu_axi_arready;
    wire [`RV_IFU_BUS_TAG-1:0]      ifu_axi_arid;
    wire [`RV_XLEN-1:0]             ifu_axi_araddr;
    wire [3:0]                      ifu_axi_arregion;
    wire [7:0]                      ifu_axi_arlen;
    wire [2:0]                      ifu_axi_arsize;
    wire [1:0]                      ifu_axi_arburst;
    wire                            ifu_axi_arlock;
    wire [3:0]                      ifu_axi_arcache;
    wire [2:0]                      ifu_axi_arprot;
    wire [3:0]                      ifu_axi_arqos;

    wire                            ifu_axi_rvalid;
    wire                            ifu_axi_rready;
    wire [`RV_IFU_BUS_TAG-1:0]      ifu_axi_rid;
    wire [63:0]                     ifu_axi_rdata;
    wire [1:0]                      ifu_axi_rresp;
    wire                            ifu_axi_rlast;

    //-------------------------- SB AXI signals--------------------------
    // AXI Write Channels
    wire                            sb_axi_awvalid;
    wire                            sb_axi_awready;
    wire [`RV_SB_BUS_TAG-1:0]       sb_axi_awid;
    wire [`RV_XLEN-1:0]             sb_axi_awaddr;
    wire [3:0]                      sb_axi_awregion;
    wire [7:0]                      sb_axi_awlen;
    wire [2:0]                      sb_axi_awsize;
    wire [1:0]                      sb_axi_awburst;
    wire                            sb_axi_awlock;
    wire [3:0]                      sb_axi_awcache;
    wire [2:0]                      sb_axi_awprot;
    wire [3:0]                      sb_axi_awqos;

    wire                            sb_axi_wvalid;
    wire                            sb_axi_wready;
    wire [`RV_BUS_WIDTH-1:0]        sb_axi_wdata;
    wire [`RV_BUS_BYTES-1:0]        sb_axi_wstrb;
    wire                            sb_axi_wlast;

    wire                            sb_axi_bvalid;
    wire                            sb_axi_bready;
    wire [1:0]                      sb_axi_bresp;
    wire [`RV_SB_BUS_TAG-1:0]       sb_axi_bid;

    // AXI Read Channels
    wire                            sb_axi_arvalid;
    wire                            sb_axi_arready;
    wire [`RV_SB_BUS_TAG-1:0]       sb_axi_arid;
    wire [`RV_XLEN-1:0]             sb_axi_araddr;
    wire [3:0]                      sb_axi_arregion;
    wire [7:0]                      sb_axi_arlen;
    wire [2:0]                      sb_axi_arsize;
    wire [1:0]                      sb_axi_arburst;
    wire                            sb_axi_arlock;
    wire [3:0]                      sb_axi_arcache;
    wire [2:0]                      sb_axi_arprot;
    wire [3:0]                      sb_axi_arqos;

    wire                            sb_axi_rvalid;
    wire                            sb_axi_rready;
    wire [`RV_SB_BUS_TAG-1:0]       sb_axi_rid;
    wire [`RV_BUS_WIDTH-1:0]        sb_axi_rdata;
    wire [1:0]                      sb_axi_rresp;
    wire                            sb_axi_rlast;

   //-------------------------- DMA AXI signals--------------------------
   // AXI Write Channels
    wire                            dma_axi_awvalid;
    wire                            dma_axi_awready;
    wire [`RV_DMA_BUS_TAG-1:0]      dma_axi_awid;
    wire [`RV_XLEN-1:0]             dma_axi_awaddr;
    wire [2:0]                      dma_axi_awsize;
    wire [2:0]                      dma_axi_awprot;
    wire [7:0]                      dma_axi_awlen;
    wire [1:0]                      dma_axi_awburst;


    wire                            dma_axi_wvalid;
    wire                            dma_axi_wready;
    wire [`RV_BUS_WIDTH-1:0]        dma_axi_wdata;
    wire [`RV_BUS_BYTES-1:0]        dma_axi_wstrb;
    wire                            dma_axi_wlast;

    wire                            dma_axi_bvalid;
    wire                            dma_axi_bready;
    wire [1:0]                      dma_axi_bresp;
    wire [`RV_DMA_BUS_TAG-1:0]      dma_axi_bid;

    // AXI Read Channels
    wire                            dma_axi_arvalid;
    wire                            dma_axi_arready;
    wire [`RV_DMA_BUS_TAG-1:0]      dma_axi_arid;
    wire [`RV_XLEN-1:0]             dma_axi_araddr;
    wire [2:0]                      dma_axi_arsize;
    wire [2:0]                      dma_axi_arprot;
    wire [7:0]                      dma_axi_arlen;
    wire [1:0]                      dma_axi_arburst;

    wire                            dma_axi_rvalid;
    wire                            dma_axi_rready;
    wire [`RV_DMA_BUS_TAG-1:0]      dma_axi_rid;
    wire [`RV_BUS_WIDTH-1:0]        dma_axi_rdata;
    wire [1:0]                      dma_axi_rresp;
    wire                            dma_axi_rlast;

    wire                            lmem_axi_arvalid;
    wire                            lmem_axi_arready;

    wire                            lmem_axi_rvalid;
    wire [`RV_LSU_BUS_TAG-1:0]      lmem_axi_rid;
    wire [1:0]                      lmem_axi_rresp;
    wire [`RV_BUS_WIDTH-1:0]        lmem_axi_rdata;
    wire                            lmem_axi_rlast;
    wire                            lmem_axi_rready;

    wire                            lmem_axi_awvalid;
    wire                            lmem_axi_awready;

    wire                            lmem_axi_wvalid;
    wire                            lmem_axi_wready;

    wire [1:0]                      lmem_axi_bresp;
    wire                            lmem_axi_bvalid;
    wire [`RV_LSU_BUS_TAG-1:0]      lmem_axi_bid;
    wire                            lmem_axi_bready;


    string                          abi_reg[32]; // ABI register names
    wire[`RV_BUS_WIDTH-1:0]         WriteData;
    wire                            tck, tms, tdi, tdo, trstn, srstn;
    wire [31:0]                     minstret[2], mcycle[2];

`define DEC rvtop.veer.dec

    assign mailbox_write = lmem.mailbox_write;
    assign WriteData = lmem.WriteData;
    assign mailbox_data_val = WriteData[7:0] > 8'h5 && WriteData[7:0] < 8'h7f;

    assign minstret[0] = `DEC.tlu.tlumt[0].tlu.minstretl;
    assign mcycle[0]   = `DEC.tlu.tlumt[0].tlu.mcyclel;
    assign minstret[1] = `DEC.tlu.tlumt[`RV_NUM_THREADS-1].tlu.minstretl;
    assign mcycle[1]   = `DEC.tlu.tlumt[`RV_NUM_THREADS-1].tlu.mcyclel;


    parameter MAX_CYCLES = 10_000_000;

    integer fd, tp, el;

    always @(negedge core_clk) begin
        cycleCnt <= cycleCnt+1;
        // Timeout monitor
        if(cycleCnt == MAX_CYCLES) begin
            $display ("Hit max cycle count (%0d) .. stopping", cycleCnt);
            $display("TEST_FAILED");
            `ifdef TB_SILENT_FAIL
                $finish;
            `else
                $fatal;
            `endif // TB_SILENT_FAIL
        end
        // console Monitor
        if( mailbox_data_val & mailbox_write) begin
            $fwrite(fd,"%c", WriteData[7:0]);
            $write("%c", WriteData[7:0]);
        end

        if(mailbox_write && (WriteData[7:0] == 8'hFF || WriteData[7:0] == 8'h01)) begin
            if (mem_signature_begin < mem_signature_end) begin
                dump_signature();
            end
        end
        // End Of test monitor
        if(mailbox_write && WriteData[7:0] == 8'hFF) begin
            $display("TEST_PASSED");
            $display("\nFinished hart0 : minstret = %0d, mcycle = %0d", minstret[0],mcycle[0]);
            if(`RV_NUM_THREADS == 2)
                $display("Finished hart1 : minstret = %0d, mcycle = %0d", minstret[1], mcycle[1]);
            $display("See \"exec.log\" for execution trace with register updates..\n");
            $finish;
        end
        else if(mailbox_write && WriteData[7:0] == 8'h01) begin
            $display("TEST_FAILED");
            `ifdef TB_SILENT_FAIL
                $finish;
            `else
                $fatal;
            `endif // TB_SILENT_FAIL
        end
    end

    if (`RV_XLEN == 32) begin
        // trace monitor
        always @(posedge core_clk) begin
            wb_valid[1:0]  <= '{`DEC.dec_i1_wen_wb,   `DEC.dec_i0_wen_wb};
            wb_dest        <= '{`DEC.dec_i1_waddr_wb, `DEC.dec_i0_waddr_wb};
            wb_data        <= '{`DEC.dec_i1_wdata_wb, `DEC.dec_i0_wdata_wb};
            wb_tid         <= '{`DEC.dec_i1_tid_wb,   `DEC.dec_i0_tid_wb};
            for(int t=0; t<`RV_NUM_THREADS; t++) begin
                if (trace_rv_i_valid_ip[t] !== 0) begin
                    $fwrite(tp,"t%0d %b,%h,%h,%0h,%0h,3,%b,%h,%h,%b\n",t, trace_rv_i_valid_ip[t], trace_rv_i_address_ip[t][63:32], trace_rv_i_address_ip[t][31:0],
                        trace_rv_i_insn_ip[t][63:32], trace_rv_i_insn_ip[t][31:0],trace_rv_i_exception_ip[t],trace_rv_i_ecause_ip[t],
                        trace_rv_i_tval_ip[t],trace_rv_i_interrupt_ip[t]);
                    // Basic trace - no exception register updates
                    // #1 0 ee000000 b0201073 c 0b02       00000000
                    for (int i=0; i<2; i++)
                        if (trace_rv_i_valid_ip[t][i]==1) begin
                            bit i0;
                            i0 = i != 0 || trace_rv_i_valid_ip[t]!=3 && wb_tid[1] == t && wb_valid[1];
                            commit_count[t]++;
                            $fwrite (el, "%10d : %8s %0d %h %h%13s ; %s\n",cycleCnt, $sformatf("#%0d",commit_count[t]), t,
                                    trace_rv_i_address_ip[t][31+i*32 -:32], trace_rv_i_insn_ip[t][31+i*32-:32],
                                    (wb_dest[i0] !=0 && wb_valid[i0]) ?  $sformatf("%s=%h", abi_reg[wb_dest[i0]], wb_data[i0]) : "             ",
                                    dasm(trace_rv_i_insn_ip[t][31+i*32 -:32], trace_rv_i_address_ip[t][31+i*32-:32], wb_dest[i0] & {5{wb_valid[i0]}}, wb_data[i0], t)
                                    );
                        end
                end
                if(`DEC.dec_nonblock_load_wen[t]) begin
                    $fwrite (el, "%10d : %10d%22s=%h ; nbL\n", cycleCnt, `DEC.lsu_nonblock_load_data_tid, abi_reg[`DEC.dec_nonblock_load_waddr[t]], `DEC.lsu_nonblock_load_data);
                    tb_top.gpr[t][`DEC.dec_nonblock_load_waddr[t]] = `DEC.lsu_nonblock_load_data;
                end
            end
            if(`DEC.exu_div_wren) begin
                $fwrite (el, "%10d : %10d%22s=%h ; nbD\n", cycleCnt, `DEC.div_tid_wb, abi_reg[`DEC.div_waddr_wb], `DEC.exu_div_result);
                tb_top.gpr[`DEC.div_tid_wb][`DEC.div_waddr_wb] = `DEC.exu_div_result;
            end
        end
    end else if (`RV_XLEN == 64) begin
        // trace monitor
        always @(posedge core_clk) begin
            wb_valid[1:0]  <= '{`DEC.dec_i1_wen_wb,   `DEC.dec_i0_wen_wb};
            wb_dest        <= '{`DEC.dec_i1_waddr_wb, `DEC.dec_i0_waddr_wb};
            wb_data        <= '{`DEC.dec_i1_wdata_wb, `DEC.dec_i0_wdata_wb};
            wb_tid         <= '{`DEC.dec_i1_tid_wb,   `DEC.dec_i0_tid_wb};
            for(int t=0; t<`RV_NUM_THREADS; t++) begin
                if (trace_rv_i_valid_ip[t] !== 0) begin
                    $fwrite(tp,"t%0d %b,%h,%h,%h,%h,%0h,%0h,3,%b,%h,%h,%b\n",t, trace_rv_i_valid_ip[t],
                        trace_rv_i_address_ip[t][127:96], trace_rv_i_address_ip[t][95:64],
                        trace_rv_i_address_ip[t][63:32],  trace_rv_i_address_ip[t][31:0],
                        trace_rv_i_insn_ip[t][63:32], trace_rv_i_insn_ip[t][31:0],
                        trace_rv_i_exception_ip[t], trace_rv_i_ecause_ip[t],
                        trace_rv_i_tval_ip[t], trace_rv_i_interrupt_ip[t]);
                    // Basic trace - no exception register updates
                    // #1 0 ee000000 b0201073 c 0b02       00000000
                    for (int i=0; i<2; i++)
                        if (trace_rv_i_valid_ip[t][i]==1) begin
                            bit i0;
                            i0 = i != 0 || trace_rv_i_valid_ip[t]!=3 && wb_tid[1] == t && wb_valid[1];
                            commit_count[t]++;
                            $fwrite (el, "%10d : %8s %0d %h %h %h%13s ; %s\n",cycleCnt, $sformatf("#%0d",commit_count[t]), t,
                                    trace_rv_i_address_ip[t][63+i*64 -:32], trace_rv_i_address_ip[t][31+i*64 -:32], trace_rv_i_insn_ip[t][31+i*32-:32],
                                    (wb_dest[i0] !=0 && wb_valid[i0]) ?  $sformatf("%s=%h %h", abi_reg[wb_dest[i0]], wb_data[i0][63:32], wb_data[i0][31:0]) : "             ",
                                    // TODO: Add support for dasm64
                                    dasm(trace_rv_i_insn_ip[t][31+i*32 -:32], trace_rv_i_address_ip[t][31+i*32-:32], wb_dest[i0] & {5{wb_valid[i0]}}, wb_data[i0][31:0], t)
                                    );
                        end
                end
                if(`DEC.dec_nonblock_load_wen[t]) begin
                    $fwrite (el, "%10d : %10d%22s=%h ; nbL\n", cycleCnt, `DEC.lsu_nonblock_load_data_tid, abi_reg[`DEC.dec_nonblock_load_waddr[t]], `DEC.lsu_nonblock_load_data);
                    tb_top.gpr[t][`DEC.dec_nonblock_load_waddr[t]] = `DEC.lsu_nonblock_load_data;
                end
            end
            if(`DEC.exu_div_wren) begin
                $fwrite (el, "%10d : %10d%22s=%h ; nbD\n", cycleCnt, `DEC.div_tid_wb, abi_reg[`DEC.div_waddr_wb], `DEC.exu_div_result);
                tb_top.gpr[`DEC.div_tid_wb][`DEC.div_waddr_wb] = `DEC.exu_div_result;
            end
        end
    end

    initial begin
        abi_reg[0] = "zero";
        abi_reg[1] = "ra";
        abi_reg[2] = "sp";
        abi_reg[3] = "gp";
        abi_reg[4] = "tp";
        abi_reg[5] = "t0";
        abi_reg[6] = "t1";
        abi_reg[7] = "t2";
        abi_reg[8] = "s0";
        abi_reg[9] = "s1";
        abi_reg[10] = "a0";
        abi_reg[11] = "a1";
        abi_reg[12] = "a2";
        abi_reg[13] = "a3";
        abi_reg[14] = "a4";
        abi_reg[15] = "a5";
        abi_reg[16] = "a6";
        abi_reg[17] = "a7";
        abi_reg[18] = "s2";
        abi_reg[19] = "s3";
        abi_reg[20] = "s4";
        abi_reg[21] = "s5";
        abi_reg[22] = "s6";
        abi_reg[23] = "s7";
        abi_reg[24] = "s8";
        abi_reg[25] = "s9";
        abi_reg[26] = "s10";
        abi_reg[27] = "s11";
        abi_reg[28] = "t3";
        abi_reg[29] = "t4";
        abi_reg[30] = "t5";
        abi_reg[31] = "t6";
    // tie offs
        jtag_id[31:28] = 4'b1;
        jtag_id[27:12] = '0;
        jtag_id[11:1]  = 11'h45;
        reset_vector = {`RV_XLEN{1'b0}};
        nmi_vector   = {8'hee, {`RV_XLEN-8{1'b0}}};
        nmi_int   = 0;

        $readmemh("program.hex",  lmem.mem);
        $readmemh("program.hex",  imem.mem);
        tp = $fopen("trace_port.csv","w");
        el = $fopen("exec.log","w");
        $fwrite (el, "//   Cycle : #inst  hart   pc    opcode    reg=value   ; mnemonic\n");
        $fwrite (el, "//---------------------------------------------------------------\n");
        fd = $fopen("console.log","w");
        preload_dccm();
        preload_iccm();

`ifndef VERILATOR
        if($test$plusargs("dumpon")) $dumpvars;
        forever  core_clk = #5 ~core_clk;
`endif
    end


    assign rst_l = cycleCnt > 5 && srstn;
    assign porst_l = cycleCnt > 2;

   //=========================================================================-
   // RTL instance
   //=========================================================================-
eh2_veer_wrapper rvtop (
    .rst_l                  ( rst_l),
    .dbg_rst_l              ( porst_l       ),
    .clk                    ( core_clk      ),
    .rst_vec                ( reset_vector[`RV_XLEN-1:1]),
    .nmi_int                ( nmi_int       ),
    .nmi_vec                ( nmi_vector[`RV_XLEN-1:1]),
    .jtag_id                ( jtag_id[31:1]),

`ifdef RV_BUILD_AHB_LITE
    .haddr                  ( ic_haddr      ),
    .hburst                 ( ic_hburst     ),
    .hmastlock              ( ),
    .hprot                  ( ic_hprot      ),
    .hsize                  ( ic_hsize      ),
    .htrans                 ( ic_htrans     ),
    .hwrite                 ( ic_hwrite     ),

    .hrdata                 ( ic_hrdata     ),
    .hready                 ( ic_hready     ),
    .hresp                  ( ic_hresp      ),

    //---------------------------------------------------------------
    // Debug AHB Master
    //---------------------------------------------------------------
    .sb_haddr               (),
    .sb_hburst              (),
    .sb_hmastlock           (),
    .sb_hprot               (),
    .sb_hsize               (),
    .sb_htrans              (),
    .sb_hwrite              (),
    .sb_hwdata              (),

    .sb_hrdata              ('0),
    .sb_hready              ('1),
    .sb_hresp               ('0),

    //---------------------------------------------------------------
    // LSU AHB Master
    //---------------------------------------------------------------
    .lsu_haddr              ( lsu_haddr       ),
    .lsu_hburst             ( lsu_hburst      ),
    .lsu_hmastlock          ( ),
    .lsu_hprot              ( lsu_hprot       ),
    .lsu_hsize              ( lsu_hsize       ),
    .lsu_htrans             ( lsu_htrans      ),
    .lsu_hwrite             ( lsu_hwrite      ),
    .lsu_hwdata             ( lsu_hwdata      ),

    .lsu_hrdata             ( lsu_hrdata      ),
    .lsu_hready             ( lsu_hready      ),
    .lsu_hresp              ( lsu_hresp       ),

    //---------------------------------------------------------------
    // DMA Slave
    //---------------------------------------------------------------
    .dma_haddr              ( dma_haddr      ),
    .dma_hburst             ( dma_hburst     ),
    .dma_hmastlock          ( dma_hmastlock  ),
    .dma_hprot              ( dma_hprot      ),
    .dma_hsize              ( dma_hsize      ),
    .dma_htrans             ( dma_htrans     ),
    .dma_hwrite             ( dma_hwrite     ),
    .dma_hwdata             ( dma_hwdata     ),

    .dma_hrdata             ( dma_hrdata     ),
    .dma_hresp              ( dma_hresp      ),
    .dma_hsel               ( dma_hsel       ),
    .dma_hreadyin           ( dma_hready     ),
    .dma_hreadyout          ( dma_hready     ),
`endif
`ifdef RV_BUILD_AXI4
//-------------------------- LSU AXI signals--------------------------
    // AXI Write Channels
    .lsu_axi_awvalid        (lsu_axi_awvalid),
    .lsu_axi_awready        (lsu_axi_awready),
    .lsu_axi_awid           (lsu_axi_awid),
    .lsu_axi_awaddr         (lsu_axi_awaddr),
    .lsu_axi_awregion       (lsu_axi_awregion),
    .lsu_axi_awlen          (lsu_axi_awlen),
    .lsu_axi_awsize         (lsu_axi_awsize),
    .lsu_axi_awburst        (lsu_axi_awburst),
    .lsu_axi_awlock         (lsu_axi_awlock),
    .lsu_axi_awcache        (lsu_axi_awcache),
    .lsu_axi_awprot         (lsu_axi_awprot),
    .lsu_axi_awqos          (lsu_axi_awqos),

    .lsu_axi_wvalid         (lsu_axi_wvalid),
    .lsu_axi_wready         (lsu_axi_wready),
    .lsu_axi_wdata          (lsu_axi_wdata),
    .lsu_axi_wstrb          (lsu_axi_wstrb),
    .lsu_axi_wlast          (lsu_axi_wlast),

    .lsu_axi_bvalid         (lsu_axi_bvalid),
    .lsu_axi_bready         (lsu_axi_bready),
    .lsu_axi_bresp          (lsu_axi_bresp),
    .lsu_axi_bid            (lsu_axi_bid),


    .lsu_axi_arvalid        (lsu_axi_arvalid),
    .lsu_axi_arready        (lsu_axi_arready),
    .lsu_axi_arid           (lsu_axi_arid),
    .lsu_axi_araddr         (lsu_axi_araddr),
    .lsu_axi_arregion       (lsu_axi_arregion),
    .lsu_axi_arlen          (lsu_axi_arlen),
    .lsu_axi_arsize         (lsu_axi_arsize),
    .lsu_axi_arburst        (lsu_axi_arburst),
    .lsu_axi_arlock         (lsu_axi_arlock),
    .lsu_axi_arcache        (lsu_axi_arcache),
    .lsu_axi_arprot         (lsu_axi_arprot),
    .lsu_axi_arqos          (lsu_axi_arqos),

    .lsu_axi_rvalid         (lsu_axi_rvalid),
    .lsu_axi_rready         (lsu_axi_rready),
    .lsu_axi_rid            (lsu_axi_rid),
    .lsu_axi_rdata          (lsu_axi_rdata),
    .lsu_axi_rresp          (lsu_axi_rresp),
    .lsu_axi_rlast          (lsu_axi_rlast),

    //-------------------------- IFU AXI signals--------------------------
    // AXI Write Channels
    .ifu_axi_awvalid        (ifu_axi_awvalid),
    .ifu_axi_awready        (ifu_axi_awready),
    .ifu_axi_awid           (ifu_axi_awid),
    .ifu_axi_awaddr         (ifu_axi_awaddr),
    .ifu_axi_awregion       (ifu_axi_awregion),
    .ifu_axi_awlen          (ifu_axi_awlen),
    .ifu_axi_awsize         (ifu_axi_awsize),
    .ifu_axi_awburst        (ifu_axi_awburst),
    .ifu_axi_awlock         (ifu_axi_awlock),
    .ifu_axi_awcache        (ifu_axi_awcache),
    .ifu_axi_awprot         (ifu_axi_awprot),
    .ifu_axi_awqos          (ifu_axi_awqos),

    .ifu_axi_wvalid         (ifu_axi_wvalid),
    .ifu_axi_wready         (ifu_axi_wready),
    .ifu_axi_wdata          (ifu_axi_wdata),
    .ifu_axi_wstrb          (ifu_axi_wstrb),
    .ifu_axi_wlast          (ifu_axi_wlast),

    .ifu_axi_bvalid         (ifu_axi_bvalid),
    .ifu_axi_bready         (ifu_axi_bready),
    .ifu_axi_bresp          (ifu_axi_bresp),
    .ifu_axi_bid            (ifu_axi_bid),

    .ifu_axi_arvalid        (ifu_axi_arvalid),
    .ifu_axi_arready        (ifu_axi_arready),
    .ifu_axi_arid           (ifu_axi_arid),
    .ifu_axi_araddr         (ifu_axi_araddr),
    .ifu_axi_arregion       (ifu_axi_arregion),
    .ifu_axi_arlen          (ifu_axi_arlen),
    .ifu_axi_arsize         (ifu_axi_arsize),
    .ifu_axi_arburst        (ifu_axi_arburst),
    .ifu_axi_arlock         (ifu_axi_arlock),
    .ifu_axi_arcache        (ifu_axi_arcache),
    .ifu_axi_arprot         (ifu_axi_arprot),
    .ifu_axi_arqos          (ifu_axi_arqos),

    .ifu_axi_rvalid         (ifu_axi_rvalid),
    .ifu_axi_rready         (ifu_axi_rready),
    .ifu_axi_rid            (ifu_axi_rid),
    .ifu_axi_rdata          (ifu_axi_rdata),
    .ifu_axi_rresp          (ifu_axi_rresp),
    .ifu_axi_rlast          (ifu_axi_rlast),

    //-------------------------- SB AXI signals--------------------------
    // AXI Write Channels
    .sb_axi_awvalid         (sb_axi_awvalid),
    .sb_axi_awready         (sb_axi_awready),
    .sb_axi_awid            (sb_axi_awid),
    .sb_axi_awaddr          (sb_axi_awaddr),
    .sb_axi_awregion        (sb_axi_awregion),
    .sb_axi_awlen           (sb_axi_awlen),
    .sb_axi_awsize          (sb_axi_awsize),
    .sb_axi_awburst         (sb_axi_awburst),
    .sb_axi_awlock          (sb_axi_awlock),
    .sb_axi_awcache         (sb_axi_awcache),
    .sb_axi_awprot          (sb_axi_awprot),
    .sb_axi_awqos           (sb_axi_awqos),

    .sb_axi_wvalid          (sb_axi_wvalid),
    .sb_axi_wready          (sb_axi_wready),
    .sb_axi_wdata           (sb_axi_wdata),
    .sb_axi_wstrb           (sb_axi_wstrb),
    .sb_axi_wlast           (sb_axi_wlast),

    .sb_axi_bvalid          (sb_axi_bvalid),
    .sb_axi_bready          (sb_axi_bready),
    .sb_axi_bresp           (sb_axi_bresp),
    .sb_axi_bid             (sb_axi_bid),


    .sb_axi_arvalid         (sb_axi_arvalid),
    .sb_axi_arready         (sb_axi_arready),
    .sb_axi_arid            (sb_axi_arid),
    .sb_axi_araddr          (sb_axi_araddr),
    .sb_axi_arregion        (sb_axi_arregion),
    .sb_axi_arlen           (sb_axi_arlen),
    .sb_axi_arsize          (sb_axi_arsize),
    .sb_axi_arburst         (sb_axi_arburst),
    .sb_axi_arlock          (sb_axi_arlock),
    .sb_axi_arcache         (sb_axi_arcache),
    .sb_axi_arprot          (sb_axi_arprot),
    .sb_axi_arqos           (sb_axi_arqos),

    .sb_axi_rvalid          (sb_axi_rvalid),
    .sb_axi_rready          (sb_axi_rready),
    .sb_axi_rid             (sb_axi_rid),
    .sb_axi_rdata           (sb_axi_rdata),
    .sb_axi_rresp           (sb_axi_rresp),
    .sb_axi_rlast           (sb_axi_rlast),

    //-------------------------- DMA AXI signals--------------------------
    // AXI Write Channels
    .dma_axi_awvalid        (dma_axi_awvalid),
    .dma_axi_awready        (dma_axi_awready),
    .dma_axi_awid           ('0),
    .dma_axi_awaddr         (lsu_axi_awaddr),
    .dma_axi_awsize         (lsu_axi_awsize),
    .dma_axi_awprot         (lsu_axi_awprot),
    .dma_axi_awlen          (lsu_axi_awlen),
    .dma_axi_awburst        (lsu_axi_awburst),


    .dma_axi_wvalid         (dma_axi_wvalid),
    .dma_axi_wready         (dma_axi_wready),
    .dma_axi_wdata          (lsu_axi_wdata),
    .dma_axi_wstrb          (lsu_axi_wstrb),
    .dma_axi_wlast          (lsu_axi_wlast),

    .dma_axi_bvalid         (dma_axi_bvalid),
    .dma_axi_bready         (dma_axi_bready),
    .dma_axi_bresp          (dma_axi_bresp),
    .dma_axi_bid            (),


    .dma_axi_arvalid        (dma_axi_arvalid),
    .dma_axi_arready        (dma_axi_arready),
    .dma_axi_arid           ('0),
    .dma_axi_araddr         (lsu_axi_araddr),
    .dma_axi_arsize         (lsu_axi_arsize),
    .dma_axi_arprot         (lsu_axi_arprot),
    .dma_axi_arlen          (lsu_axi_arlen),
    .dma_axi_arburst        (lsu_axi_arburst),

    .dma_axi_rvalid         (dma_axi_rvalid),
    .dma_axi_rready         (dma_axi_rready),
    .dma_axi_rid            (),
    .dma_axi_rdata          (dma_axi_rdata),
    .dma_axi_rresp          (dma_axi_rresp),
    .dma_axi_rlast          (dma_axi_rlast),
`endif
    .timer_int              ( '0  ),
    .extintsrc_req          ( '0  ),

    .lsu_bus_clk_en         ( 1'b1  ),
    .ifu_bus_clk_en         ( 1'b1  ),
    .dbg_bus_clk_en         ( 1'b1  ),
    .dma_bus_clk_en         ( 1'b1  ),


    .dccm_ext_in_pkt        ('0),
    .iccm_ext_in_pkt        ('0),
    .ic_data_ext_in_pkt     ('0),
    .ic_tag_ext_in_pkt      ('0),
    .btb_ext_in_pkt         ('0),
    .trace_rv_i_insn_ip     (trace_rv_i_insn_ip),
    .trace_rv_i_address_ip  (trace_rv_i_address_ip),
    .trace_rv_i_valid_ip    (trace_rv_i_valid_ip),
    .trace_rv_i_exception_ip(trace_rv_i_exception_ip),
    .trace_rv_i_ecause_ip   (trace_rv_i_ecause_ip),
    .trace_rv_i_interrupt_ip(trace_rv_i_interrupt_ip),
    .trace_rv_i_tval_ip     (trace_rv_i_tval_ip),

    .jtag_tck               ( tck  ),
    .jtag_tms               ( tms  ),
    .jtag_tdi               ( tdi  ),
    .jtag_trst_n            ( trstn  ),
    .jtag_tdo               ( tdo ),

    .mpc_debug_halt_ack     ( ),
    .mpc_debug_halt_req     ('0),
    .mpc_debug_run_ack      (),
    .mpc_debug_run_req      ('1),
    .mpc_reset_run_req      ('1),
     .debug_brkpt_status    (),

    .i_cpu_halt_req         ('0),
    .o_cpu_halt_ack         (),
    .o_cpu_halt_status      (),
    .i_cpu_run_req          ('0),
    .o_debug_mode_status    (),
    .o_cpu_run_ack          (),

    .dec_tlu_perfcnt0       (),
    .dec_tlu_perfcnt1       (),
    .dec_tlu_perfcnt2       (),
    .dec_tlu_perfcnt3       (),
    .dec_tlu_mhartstart     (),

    .soft_int               ('0),
    .core_id                ('0),
    .scan_mode              ( 1'b0 ),
    .mbist_mode             ( 1'b0 )

);

bit openocd;
initial begin
    openocd = $test$plusargs("openocd");
end

SimJTAG #2 jtag_drv(

    .clock(core_clk),
    .reset(~porst_l),

    .enable(openocd),
    .init_done(porst_l),

    .jtag_TCK(tck),
    .jtag_TMS(tms),
    .jtag_TDI(tdi),
    .jtag_TRSTn(trstn),

    .jtag_TDO_data(tdo),
    .jtag_TDO_driven(1'b1),
    .srstn(srstn),

    .exit()
);


function string dmi_reg_name ( int ra);
    case(ra)
    'h4:  return "DATA0    ";
    'h5:  return "DATA1    ";
    'h10: return "DM_CNTL  ";
    'h11: return "DM_STATUS";
    'h15: return "HAWINDOW ";
    'h16: return "AB_CS    ";
    'h17: return "AB_CMD   ";
    'h38: return "SB_CS    ";
    'h39: return "SB_ADDR0 ";
    'h3a: return "SB_ADDR1 ";
    'h3c: return "SB_DATA0 ";
    'h3d: return "SB_DATA1 ";
    'h3e: return "SB_DATA2 ";
    'h3f: return "SB_DATA3 ";
    'h40: return "HALTSUM  ";
    default: return $sformatf("0x%0h   ", ra);
    endcase
endfunction

bit reg_read;
bit[7:0] reg_addr;

// Debug Module monitor
always @ (posedge core_clk) begin
    if(`CPU_TOP.dmi_reg_wr_en)
        $display("DM: %10d Write %s = %h", cycleCnt, dmi_reg_name(`CPU_TOP.dmi_reg_addr),`CPU_TOP.dmi_reg_wdata);
    reg_read <= `CPU_TOP.dmi_reg_en & ~`CPU_TOP.dmi_reg_wr_en;
    reg_addr <= `CPU_TOP.dmi_reg_addr;
    if(reg_read)
        $display("DM: %10d Read  %s = %h", cycleCnt, dmi_reg_name(reg_addr),`CPU_TOP.dmi_reg_rdata);
end

`ifdef RV_BUILD_AHB_LITE

ahb_sif imem (
     // Inputs
     .HWDATA({`RV_BUS_WIDTH{1'b0}}),
     .HCLK(core_clk),
     .HSEL(1'b1),
     .HPROT(ic_hprot),
     .HWRITE(ic_hwrite),
     .HTRANS(ic_htrans),
     .HSIZE(ic_hsize),
     .HREADY(ic_hready),
     .HRESETn(rst_l),
     .HADDR(ic_haddr),
     .HBURST(ic_hburst),

     // Outputs
     .HREADYOUT(ic_hready),
     .HRESP(ic_hresp),
     .HRDATA(ic_hrdata)
);


ahb_sif lmem (
     // Inputs
     .HWDATA(lmem_hwdata),
     .HCLK(core_clk),
     .HSEL(lmem_hsel),
     .HPROT(lmem_hprot),
     .HWRITE(lmem_hwrite),
     .HTRANS(lmem_htrans),
     .HSIZE(lmem_hsize),
     .HREADY(lmem_hready),
     .HRESETn(rst_l),
     .HADDR(lmem_haddr),
     .HBURST(lmem_hburst),

     // Outputs
     .HREADYOUT(lmem_hready),
     .HRESP(lmem_hresp),
     .HRDATA(lmem_hrdata)
);

ahb_lsu_dma_bridge bridge (
    .clk(core_clk),
    .reset_l(rst_l),

    .m_ahb_haddr(lsu_haddr),
    .m_ahb_hburst(lsu_hburst),
    .m_ahb_hmastlock(),
    .m_ahb_hprot(lsu_hprot),
    .m_ahb_hsize(lsu_hsize),
    .m_ahb_htrans(lsu_htrans),
    .m_ahb_hwrite(lsu_hwrite),
    .m_ahb_hwdata(lsu_hwdata),
    .m_ahb_hsel(1'b1),
    .m_ahb_hreadyin(lsu_hready),
    .m_ahb_hrdata(lsu_hrdata),
    .m_ahb_hreadyout(lsu_hready),
    .m_ahb_hresp(lsu_hresp),

    .s0_ahb_hsel(lmem_hsel),
    .s0_ahb_haddr(lmem_haddr),
    .s0_ahb_hburst(lmem_hburst),
    .s0_ahb_hmastlock(lmem_hmastlock),
    .s0_ahb_hprot(lmem_hprot),
    .s0_ahb_hsize(lmem_hsize),
    .s0_ahb_htrans(lmem_htrans),
    .s0_ahb_hwrite(lmem_hwrite),
    .s0_ahb_hwdata(lmem_hwdata),
    .s0_ahb_hrdata(lmem_hrdata),
    .s0_ahb_hready(lmem_hready),
    .s0_ahb_hresp(lmem_hresp),

    .s1_ahb_hsel(dma_hsel),
    .s1_ahb_haddr(dma_haddr),
    .s1_ahb_hburst(dma_hburst),
    .s1_ahb_hmastlock(dma_hmastlock),
    .s1_ahb_hprot(dma_hprot),
    .s1_ahb_hsize(dma_hsize),
    .s1_ahb_htrans(dma_htrans),
    .s1_ahb_hwrite(dma_hwrite),
    .s1_ahb_hwdata(dma_hwdata),
    .s1_ahb_hrdata(dma_hrdata),
    .s1_ahb_hready(dma_hready),
    .s1_ahb_hresp(dma_hresp)
);

`endif


`ifdef RV_BUILD_AXI4

axi_slv #(.TAGW(`RV_IFU_BUS_TAG)) imem(
    .aclk(core_clk),
    .rst_l(rst_l),
    .arvalid(ifu_axi_arvalid),
    .arready(ifu_axi_arready),
    .araddr(ifu_axi_araddr),
    .arid(ifu_axi_arid),
    .arlen(ifu_axi_arlen),
    .arburst(ifu_axi_arburst),
    .arsize(ifu_axi_arsize),

    .rvalid(ifu_axi_rvalid),
    .rready(ifu_axi_rready),
    .rdata(ifu_axi_rdata),
    .rresp(ifu_axi_rresp),
    .rid(ifu_axi_rid),
    .rlast(ifu_axi_rlast),

    .awvalid(1'b0),
    .awready(),
    .awaddr('0),
    .awid('0),
    .awlen('0),
    .awburst('0),
    .awsize('0),

    .wdata('0),
    .wstrb('0),
    .wvalid(1'b0),
    .wready(),

    .bvalid(),
    .bready(1'b0),
    .bresp(),
    .bid()
);


axi_slv #(.TAGW(`RV_LSU_BUS_TAG)) lmem(
    .aclk(core_clk),
    .rst_l(rst_l),
    .arvalid(lmem_axi_arvalid),
    .arready(lmem_axi_arready),
    .araddr(lsu_axi_araddr),
    .arid(lsu_axi_arid),
    .arlen(lsu_axi_arlen),
    .arburst(lsu_axi_arburst),
    .arsize(lsu_axi_arsize),

    .rvalid(lmem_axi_rvalid),
    .rready(lmem_axi_rready),
    .rdata(lmem_axi_rdata),
    .rresp(lmem_axi_rresp),
    .rid(lmem_axi_rid),
    .rlast(lmem_axi_rlast),

    .awvalid(lmem_axi_awvalid),
    .awready(lmem_axi_awready),
    .awaddr(lsu_axi_awaddr),
    .awid(lsu_axi_awid),
    .awlen(lsu_axi_awlen),
    .awburst(lsu_axi_awburst),
    .awsize(lsu_axi_awsize),

    .wdata(lsu_axi_wdata),
    .wstrb(lsu_axi_wstrb),
    .wvalid(lmem_axi_wvalid),
    .wready(lmem_axi_wready),

    .bvalid(lmem_axi_bvalid),
    .bready(lmem_axi_bready),
    .bresp(lmem_axi_bresp),
    .bid(lmem_axi_bid)
);


axi_lsu_dma_bridge # (`RV_LSU_BUS_TAG,`RV_LSU_BUS_TAG ) bridge(
    .clk(core_clk),
    .reset_l(rst_l),

    .m_arvalid(lsu_axi_arvalid),
    .m_arid(lsu_axi_arid),
    .m_araddr(lsu_axi_araddr),
    .m_arready(lsu_axi_arready),

    .m_rvalid(lsu_axi_rvalid),
    .m_rready(lsu_axi_rready),
    .m_rdata(lsu_axi_rdata),
    .m_rid(lsu_axi_rid),
    .m_rresp(lsu_axi_rresp),
    .m_rlast(lsu_axi_rlast),

    .m_awvalid(lsu_axi_awvalid),
    .m_awid(lsu_axi_awid),
    .m_awaddr(lsu_axi_awaddr),
    .m_awready(lsu_axi_awready),

    .m_wvalid(lsu_axi_wvalid),
    .m_wready(lsu_axi_wready),

    .m_bresp(lsu_axi_bresp),
    .m_bvalid(lsu_axi_bvalid),
    .m_bid(lsu_axi_bid),
    .m_bready(lsu_axi_bready),

    .s0_arvalid(lmem_axi_arvalid),
    .s0_arready(lmem_axi_arready),

    .s0_rvalid(lmem_axi_rvalid),
    .s0_rid(lmem_axi_rid),
    .s0_rresp(lmem_axi_rresp),
    .s0_rdata(lmem_axi_rdata),
    .s0_rlast(lmem_axi_rlast),
    .s0_rready(lmem_axi_rready),

    .s0_awvalid(lmem_axi_awvalid),
    .s0_awready(lmem_axi_awready),

    .s0_wvalid(lmem_axi_wvalid),
    .s0_wready(lmem_axi_wready),

    .s0_bresp(lmem_axi_bresp),
    .s0_bvalid(lmem_axi_bvalid),
    .s0_bid(lmem_axi_bid),
    .s0_bready(lmem_axi_bready),


    .s1_arvalid(dma_axi_arvalid),
    .s1_arready(dma_axi_arready),

    .s1_rvalid(dma_axi_rvalid),
    .s1_rresp(dma_axi_rresp),
    .s1_rdata(dma_axi_rdata),
    .s1_rlast(dma_axi_rlast),
    .s1_rready(dma_axi_rready),

    .s1_awvalid(dma_axi_awvalid),
    .s1_awready(dma_axi_awready),

    .s1_wvalid(dma_axi_wvalid),
    .s1_wready(dma_axi_wready),

    .s1_bresp(dma_axi_bresp),
    .s1_bvalid(dma_axi_bvalid),
    .s1_bready(dma_axi_bready)
);

`endif


task preload_iccm;
bit[31:0] data;
bit[`RV_XLEN-1:0] addr, eaddr, saddr;

/*
addresses if XLEN = 32
 0xffffffe0 - ICCM start address to load
 0xffffffe4 - ICCM end address to load

addresses if XLEN = 64
 0xffffffe0 - ICCM start address to load
 0xffffffe8 - ICCM end address to load
*/
`ifndef VERILATOR
init_iccm();
`endif
addr = 'hffff_ffe0;
if (`RV_XLEN == 32) begin
    saddr = {lmem.mem[addr+3],lmem.mem[addr+2],lmem.mem[addr+1],lmem.mem[addr]};
end else if (`RV_XLEN == 64) begin
    saddr = {lmem.mem[addr+7],lmem.mem[addr+6],lmem.mem[addr+5],lmem.mem[addr+4],
             lmem.mem[addr+3],lmem.mem[addr+2],lmem.mem[addr+1],lmem.mem[addr]};
end

if ( (saddr < `RV_ICCM_SADR) || (saddr > `RV_ICCM_EADR)) return;
`ifndef RV_ICCM_ENABLE
    $display("********************************************************");
    $display("ICCM preload: there is no ICCM in VeeR, terminating !!!");
    $display("********************************************************");
    `ifdef TB_SILENT_FAIL
        $finish;
    `else
        $fatal;
    `endif // TB_SILENT_FAIL
`endif
addr = (`RV_XLEN == 32) ? (addr + 4) : (addr + 8);
if (`RV_XLEN == 32) begin
    eaddr = {lmem.mem[addr+3],lmem.mem[addr+2],lmem.mem[addr+1],lmem.mem[addr]};
end else if (`RV_XLEN == 64) begin
    eaddr = {lmem.mem[addr+7],lmem.mem[addr+6],lmem.mem[addr+5],lmem.mem[addr+4],
             lmem.mem[addr+3],lmem.mem[addr+2],lmem.mem[addr+1],lmem.mem[addr]};
end
$display("ICCM pre-load from %h to %h", saddr, eaddr);

if (`RV_XLEN == 32) begin
    for(addr= saddr; addr <= eaddr; addr+=4) begin
        data = {imem.mem[addr+3],imem.mem[addr+2],imem.mem[addr+1],imem.mem[addr]};
        slam_iccm_ram(addr, data == 0 ? 0 : {riscv_ecc32(data),data});
    end
end else if (`RV_XLEN == 64) begin
    for(addr= saddr; addr <= eaddr; addr+=8) begin
        data = {imem.mem[addr+3], imem.mem[addr+2], imem.mem[addr+1], imem.mem[addr]};
        slam_iccm_ram(addr, data == 0 ? 0 : {riscv_ecc32(data),data});

        data = {imem.mem[addr+7], imem.mem[addr+6], imem.mem[addr+5], imem.mem[addr+4]};
        slam_iccm_ram(addr+4, data == 0 ? 0 : {riscv_ecc32(data),data});
    end
end
endtask


task preload_dccm;
bit[`RV_XLEN-1:0] data;
bit[`RV_XLEN-1:0] addr, saddr, eaddr;

/*
addresses if XLEN = 32
 0xffff_fff0 - DCCM start address to load
 0xffff_fff4 - DCCM end address to load

addresses if XLEN = 64
 0xffff_fff0 - DCCM start address to load
 0xffff_fff8 - DCCM end address to load
*/
`ifndef VERILATOR
init_dccm();
`endif

addr = 'hffff_fff0;
if (`RV_XLEN == 32) begin
    saddr = {lmem.mem[addr+3],lmem.mem[addr+2],lmem.mem[addr+1],lmem.mem[addr]};
end else if (`RV_XLEN == 64) begin
    saddr = {lmem.mem[addr+7],lmem.mem[addr+6],lmem.mem[addr+5],lmem.mem[addr+4],
             lmem.mem[addr+3],lmem.mem[addr+2],lmem.mem[addr+1],lmem.mem[addr]};
end
if (saddr < `RV_DCCM_SADR || saddr > `RV_DCCM_EADR) return;
`ifndef RV_DCCM_ENABLE
    $display("********************************************************");
    $display("DCCM preload: there is no DCCM in VeeR, terminating !!!");
    $display("********************************************************");
    `ifdef TB_SILENT_FAIL
        $finish;
    `else
        $fatal;
    `endif // TB_SILENT_FAIL
`endif
addr = (`RV_XLEN == 32) ? (addr + 4) : (addr + 8);
if (`RV_XLEN == 32) begin
    eaddr = {lmem.mem[addr+3],lmem.mem[addr+2],lmem.mem[addr+1],lmem.mem[addr]};
end else if (`RV_XLEN == 64) begin
    eaddr = {lmem.mem[addr+7],lmem.mem[addr+6],lmem.mem[addr+5],lmem.mem[addr+4],
             lmem.mem[addr+3],lmem.mem[addr+2],lmem.mem[addr+1],lmem.mem[addr]};
end
$display("DCCM pre-load from %h to %h", saddr, eaddr);

if (`RV_XLEN == 32) begin
    for(addr=saddr; addr <= eaddr; addr+=4) begin
        data = {lmem.mem[addr+3],lmem.mem[addr+2],lmem.mem[addr+1],lmem.mem[addr]};
        slam_dccm_ram(addr, data == 0 ? 0 : {riscv_ecc32(data),data});
    end
end else if (`RV_XLEN == 64) begin
    for(addr=saddr; addr <= eaddr; addr+=8) begin
        data = {lmem.mem[addr+7],lmem.mem[addr+6],lmem.mem[addr+5],lmem.mem[addr+4],
                lmem.mem[addr+3],lmem.mem[addr+2],lmem.mem[addr+1],lmem.mem[addr]};
        slam_dccm_ram(addr, data == 0 ? 0 : {riscv_ecc64(data),data});
    end
end

endtask

`define ICCM_PATH `RV_TOP.mem.iccm.iccm
`ifdef VERILATOR
`define DRAM(bk) rvtop.mem.Gen_dccm_enable.dccm.mem_bank[bk].ram.ram_core
`define IRAM(bk) `ICCM_PATH.mem_bank[bk].iccm_bank.ram_core
`else
`define DRAM(bk) rvtop.mem.Gen_dccm_enable.dccm.mem_bank[bk].dccm.dccm_bank.ram_core
`define IRAM(bk) `ICCM_PATH.mem_bank[bk].iccm.iccm_bank.ram_core
`endif

task dump_signature ();
    integer fp, i;

    $display("[%0t ns] Dumping memory signature (0x%08X - 0x%08X)...",$time,
        mem_signature_begin,
        mem_signature_end
    );

    fp = $fopen("veer.signature", "w");
    for (i=mem_signature_begin; i<mem_signature_end; i=i+4) begin

        // From DCCM
`ifdef RV_DCCM_ENABLE
        if (i >= `RV_DCCM_SADR && i < `RV_DCCM_EADR) begin
            bit[38:0] data;
            int bank, indx;
            bank = get_dccm_bank(i, indx);

            case (bank)
            0: data = `DRAM(0)[indx];
            1: data = `DRAM(1)[indx];
            `ifdef RV_DCCM_NUM_BANKS_4
            2: data = `DRAM(2)[indx];
            3: data = `DRAM(3)[indx];
            `endif
            `ifdef RV_DCCM_NUM_BANKS_8
            2: data = `DRAM(2)[indx];
            3: data = `DRAM(3)[indx];
            4: data = `DRAM(4)[indx];
            5: data = `DRAM(5)[indx];
            6: data = `DRAM(6)[indx];
            7: data = `DRAM(7)[indx];
            `endif
            endcase

            $fwrite(fp, "%08X\n", data[31:0]);
        end else
`endif
        // From RAM
        begin
            $fwrite(fp, "%02X%02X%02X%02X\n",
                lmem.mem[i+3],
                lmem.mem[i+2],
                lmem.mem[i+1],
                lmem.mem[i+0]
            );
        end
    end

    $fclose(fp);
endtask

task slam_dccm_ram(input [`RV_XLEN-1:0] addr, input[`RV_DCCM_FDATA_WIDTH-1:0] data);
int bank, indx;
bank = get_dccm_bank(addr, indx);
`ifdef RV_DCCM_ENABLE
case(bank)
0: `DRAM(0)[indx] = data;
1: `DRAM(1)[indx] = data;
`ifdef RV_DCCM_NUM_BANKS_4
2: `DRAM(2)[indx] = data;
3: `DRAM(3)[indx] = data;
`endif
`ifdef RV_DCCM_NUM_BANKS_8
2: `DRAM(2)[indx] = data;
3: `DRAM(3)[indx] = data;
4: `DRAM(4)[indx] = data;
5: `DRAM(5)[indx] = data;
6: `DRAM(6)[indx] = data;
7: `DRAM(7)[indx] = data;
`endif
endcase
`endif
endtask

task init_dccm();
`ifdef RV_DCCM_ENABLE
    `DRAM(0) = '{default:`RV_DCCM_FDATA_WIDTH'(0)};
    `DRAM(1) = '{default:`RV_DCCM_FDATA_WIDTH'(0)};
`ifdef RV_DCCM_NUM_BANKS_4
    `DRAM(2) = '{default:`RV_DCCM_FDATA_WIDTH'(0)};
    `DRAM(3) = '{default:`RV_DCCM_FDATA_WIDTH'(0)};
`endif
`ifdef RV_DCCM_NUM_BANKS_8
    `DRAM(2) = '{default:`RV_DCCM_FDATA_WIDTH'(0)};
    `DRAM(3) = '{default:`RV_DCCM_FDATA_WIDTH'(0)};
    `DRAM(4) = '{default:`RV_DCCM_FDATA_WIDTH'(0)};
    `DRAM(5) = '{default:`RV_DCCM_FDATA_WIDTH'(0)};
    `DRAM(6) = '{default:`RV_DCCM_FDATA_WIDTH'(0)};
    `DRAM(7) = '{default:`RV_DCCM_FDATA_WIDTH'(0)};
`endif
`endif
endtask


task slam_iccm_ram( input[`RV_XLEN-1:0] addr, input[38:0] data);
int bank, idx;

bank = get_iccm_bank(addr, idx);
`ifdef RV_ICCM_ENABLE
case(bank) // {
  0: `IRAM(0)[idx] = data;
  1: `IRAM(1)[idx] = data;
  2: `IRAM(2)[idx] = data;
  3: `IRAM(3)[idx] = data;

 `ifdef RV_ICCM_NUM_BANKS_8
  4: `IRAM(4)[idx] = data;
  5: `IRAM(5)[idx] = data;
  6: `IRAM(6)[idx] = data;
  7: `IRAM(7)[idx] = data;
 `endif

 `ifdef RV_ICCM_NUM_BANKS_16
  4: `IRAM(4)[idx] = data;
  5: `IRAM(5)[idx] = data;
  6: `IRAM(6)[idx] = data;
  7: `IRAM(7)[idx] = data;
  8: `IRAM(8)[idx] = data;
  9: `IRAM(9)[idx] = data;
  10: `IRAM(10)[idx] = data;
  11: `IRAM(11)[idx] = data;
  12: `IRAM(12)[idx] = data;
  13: `IRAM(13)[idx] = data;
  14: `IRAM(14)[idx] = data;
  15: `IRAM(15)[idx] = data;
 `endif
endcase // }
`endif
endtask

task init_iccm;
`ifdef RV_ICCM_ENABLE
    `IRAM(0) = '{default:39'h0};
    `IRAM(1) = '{default:39'h0};
    `IRAM(2) = '{default:39'h0};
    `IRAM(3) = '{default:39'h0};

`ifdef RV_ICCM_NUM_BANKS_8
    `IRAM(4) = '{default:39'h0};
    `IRAM(5) = '{default:39'h0};
    `IRAM(6) = '{default:39'h0};
    `IRAM(7) = '{default:39'h0};
`endif

`ifdef RV_ICCM_NUM_BANKS_16
    `IRAM(4) = '{default:39'h0};
    `IRAM(5) = '{default:39'h0};
    `IRAM(6) = '{default:39'h0};
    `IRAM(7) = '{default:39'h0};
    `IRAM(8) = '{default:39'h0};
    `IRAM(9) = '{default:39'h0};
    `IRAM(10) = '{default:39'h0};
    `IRAM(11) = '{default:39'h0};
    `IRAM(12) = '{default:39'h0};
    `IRAM(13) = '{default:39'h0};
    `IRAM(14) = '{default:39'h0};
    `IRAM(15) = '{default:39'h0};
 `endif
`endif
endtask


function[6:0] riscv_ecc32(input[31:0] data);
reg[6:0] synd;
synd[0] = ^(data & 32'h56aa_ad5b);
synd[1] = ^(data & 32'h9b33_366d);
synd[2] = ^(data & 32'he3c3_c78e);
synd[3] = ^(data & 32'h03fc_07f0);
synd[4] = ^(data & 32'h03ff_f800);
synd[5] = ^(data & 32'hfc00_0000);
synd[6] = ^{data, synd[5:0]};
return synd;
endfunction

function[7:0] riscv_ecc64(input[63:0] data);
reg[7:0] synd;
synd[0] = ^(data & 64'hAB55_56AB_56AA_AD5B);
synd[1] = ^(data & 64'hD9AA_AB4D_9B33_366D);
synd[2] = ^(data & 64'hF1E1_E38E_E3C3_C78E);
synd[3] = ^(data & 64'h01FE_01FF_03FC_07F0);
synd[4] = ^(data & 64'h01FF_FE00_03FF_F800);
synd[5] = ^(data & 64'h01FF_FFFF_FC00_0000);
synd[6] = ^(data & 64'hFE00_0000_0000_0000);
synd[7] = ^{data, synd[6:0]};
return synd;
endfunction

// TODO: Check if the number of banks needs to be updated after the XLEN-related changes
function int get_dccm_bank(input[`RV_XLEN-1:0] addr,  output int bank_idx);
`ifdef RV_DCCM_NUM_BANKS_2
    bank_idx = int'(addr[`RV_DCCM_BITS-1:3]);
    return int'( addr[2]);
`elsif RV_DCCM_NUM_BANKS_4
    bank_idx = int'(addr[`RV_DCCM_BITS-1:4]);
    return int'(addr[3:2]);
`elsif RV_DCCM_NUM_BANKS_8
    bank_idx = int'(addr[`RV_DCCM_BITS-1:5]);
    return int'( addr[4:2]);
`endif
endfunction

function int get_iccm_bank(input[`RV_XLEN-1:0] addr,  output int bank_idx);
`ifdef RV_ICCM_NUM_BANKS_4
    bank_idx = int'(addr[`RV_ICCM_BITS-1:4]);
    return int'(addr[3:2]);
`elsif RV_ICCM_NUM_BANKS_8
    bank_idx = int'(addr[`RV_ICCM_BITS-1:5]);
    return int'( addr[4:2]);
`elsif RV_ICCM_NUM_BANKS_16
    bank_idx = int'(addr[`RV_ICCM_BITS-1:6]);
    return int'( addr[5:2]);
`endif
endfunction

/* verilator lint_off CASEINCOMPLETE */
`include "dasm.svi"
/* verilator lint_on CASEINCOMPLETE */



endmodule
