chipsalliance/Cores-VeeR-EH2/design/ifu/eh2_ifu_aln_ctl.sv

//********************************************************************************
// SPDX-License-Identifier: Apache-2.0
// Copyright 2020 Western Digital Corporation or its affiliates.
//
// Licensed under the Apache License, Version 2.0 (the "License");
// you may not use this file except in compliance with the License.
// You may obtain a copy of the License at
//
// http://www.apache.org/licenses/LICENSE-2.0
//
// Unless required by applicable law or agreed to in writing, software
// distributed under the License is distributed on an "AS IS" BASIS,
// WITHOUT WARRANTIES OR CONDITIONS OF ANY KIND, either express or implied.
// See the License for the specific language governing permissions and
// limitations under the License.
//********************************************************************************

//********************************************************************************
// Function: Instruction aligner
//********************************************************************************
module eh2_ifu_aln_ctl
import eh2_pkg::*;
#(
`include "eh2_param.vh"
)
  (

   input logic        dec_i1_cancel_e1,

   input logic        ifu_async_error_start,                       // ecc/parity related errors with current fetch - not sent down the pipe

   input logic [3:0]  iccm_rd_ecc_double_err,                      // This fetch has a double ICCM ecc  error.

   input logic [3:0]  ic_access_fault_f2,                          // Instruction access fault for the current fetch.
   input logic [1:0]  ic_access_fault_type_f2,                     // Instruction access fault types

   input logic [pt.BHT_GHR_SIZE-1:0]  ifu_bp_fghr_f2,              // fetch GHR
   input logic [pt.XLEN-1:1] ifu_bp_btb_target_f2,                 //  predicted RET target
   input logic [pt.BTB_TOFFSET_SIZE-1:0] ifu_bp_poffset_f2,        //  predicted target offset

   input logic [3:0]  ifu_bp_hist0_f2,                             // history counters for all 4 potential branches, bit 1, right justified
   input logic [3:0]  ifu_bp_hist1_f2,                             // history counters for all 4 potential branches, bit 1, right justified
   input logic [3:0]  ifu_bp_pc4_f2,                               // pc4 indication, right justified

   input logic [3:0] [$clog2(pt.BTB_SIZE)-1:0]    ifu_bp_fa_index_f2, // predicted branch index (fully associative option)

   input logic [3:0]  ifu_bp_way_f2,                               // way indication, right justified

   input logic [3:0]  ifu_bp_valid_f2,                             // branch valid, right justified
   input logic [3:0]  ifu_bp_ret_f2,                               // predicted ret indication, right justified

   input logic exu_flush_final,                                    // Flush from the pipeline.

   input logic dec_ib3_valid_d,                                    // valids for top 2 instruction buffers at decode
   input logic dec_ib2_valid_d,


   input logic [63:0] ifu_fetch_data,                              // fetch data in memory format - not right justified

   input logic [3:0]   ifu_fetch_val,                              // valids on a 2B boundary, right justified
   input logic [pt.XLEN-1:1]  ifu_fetch_pc,                        // starting pc of fetch


   input logic   rst_l,
   input logic   clk,
   input logic   active_clk,

   output logic i0_valid,                                      // Instruction 0 is valid
   output logic i1_valid,                                      // Instruction 1 is valid
   output logic i0_icaf,                                       // Instruction 0 has access fault
   output logic i0_icaf_second,                                // Instruction has access fault / double ecc error on last 2 bytes of 4B inst - no error on 1st 2 bytes
   output logic [1:0]  i0_icaf_type,                           // Instruction 0 access fault type

   output logic i0_dbecc,                                      // Instruction 0 has double bit ecc error
   output logic [31:0] i0_instr,                               // Instruction 0
   output logic [31:0] i1_instr,                               // Instruction 1
   output logic [pt.XLEN-1:1] i0_pc,                           // Instruction 0 PC
   output logic [pt.XLEN-1:1] i1_pc,                           // Instruction 1 PC
   output logic i0_pc4,
   output logic i1_pc4,
   output eh2_predecode_pkt_t i0_predecode,
   output eh2_predecode_pkt_t i1_predecode,

   output logic fb_consume1,                                   // Consumed one buffer. To fetch control fetch for buffer mass balance
   output logic fb_consume2,                                   // Consumed two buffers.To fetch control fetch for buffer mass balance

   output eh2_br_pkt_t i0_br_p,                               // Branch packet for I0.
   output eh2_br_pkt_t i1_br_p,                               // Branch packet for I1.

   output logic [pt.BTB_ADDR_HI:pt.BTB_ADDR_LO]  i0_bp_index,  // BP index
   output logic [pt.BHT_GHR_SIZE-1:0]            i0_bp_fghr,   // BP FGHR
   output logic [pt.BTB_BTAG_SIZE-1:0]           i0_bp_btag,   // BP tag
   output logic [pt.BTB_TOFFSET_SIZE-1:0]        i0_bp_toffset,// BP toffset
   output logic [pt.BTB_ADDR_HI:pt.BTB_ADDR_LO]  i1_bp_index,  // BP index
   output logic [pt.BHT_GHR_SIZE-1:0]            i1_bp_fghr,   // BP FGHR
   output logic [pt.BTB_BTAG_SIZE-1:0]           i1_bp_btag,   // BP tag
   output logic [pt.BTB_TOFFSET_SIZE-1:0]        i1_bp_toffset,// BP toffset

   output logic [$clog2(pt.BTB_SIZE)-1:0] i0_bp_fa_index,
   output logic [$clog2(pt.BTB_SIZE)-1:0] i1_bp_fa_index,

   output logic [1:0] pmu_instr_aligned,                       // number of inst aligned this cycle
   output logic       pmu_align_stall,                         // aligner stalled this cycle

   output logic [15:0] i0_cinst,                               // 16b compress inst for i0
   output logic [15:0] i1_cinst,                               // 16b compress inst for i1

   input  logic    scan_mode


   );

   logic [31:0]    i1instr, i0instr;
   logic [pt.XLEN-1:1]    i1pc,    i0pc;
   logic [15:0]    i1cinst, i0cinst;
   logic [pt.BTB_ADDR_HI:pt.BTB_ADDR_LO]  i1_bpindex,    i0_bpindex;
   logic [pt.BHT_GHR_SIZE-1:0]            i1_bpfghr,     i0_bpfghr;
   logic [pt.BTB_BTAG_SIZE-1:0]           i1_bpbtag,     i0_bpbtag;
   logic [pt.BTB_TOFFSET_SIZE-1:0]        i1_bptoffset,  i0_bptoffset;

   eh2_br_pkt_t i1_brp, i0_brp;

   logic         ifvalid;
   logic         shift_f1_f0, shift_f2_f0, shift_f2_f1;
   logic         fetch_to_f0, fetch_to_f1, fetch_to_f2;

   logic [3:0]   f3val_in, f3val;
   logic [3:0]   f2val_in, f2val;
   logic [3:0]   f1val_in, f1val;
   logic [3:0]   f0val_in, f0val;

   logic [3:0]   sf1val, sf0val;

   logic [63:0]  f3data_in, f3data;
   logic [63:0]  f2data_in, f2data;
   logic [63:0]  f1data_in, f1data, sf1data;
   logic [63:0]  f0data_in, f0data, sf0data;

   logic [63:0]  aligndata;
   logic         first4B, first2B;
   logic         second4B, second2B;

   logic         third4B, third2B;
   logic [31:0]  uncompress0, uncompress1, uncompress2;
   logic         ibuffer_room1_more;
   logic         ibuffer_room2_more;
   logic         i1_shift;
   logic         shift_2B, shift_4B, shift_6B, shift_8B;
   logic         f1_shift_2B, f1_shift_4B, f1_shift_6B;
   logic         f2_valid, sf1_valid, sf0_valid;

   logic [31:0]         ifirst, isecond, ithird;
   logic [pt.XLEN-1:1]  f0pc_plus1, f0pc_plus2, f0pc_plus3, f0pc_plus4;
   logic [pt.XLEN-1:1]  f1pc_plus1, f1pc_plus2, f1pc_plus3;
   logic [3:0]          alignval;
   logic [pt.XLEN-1:1]  firstpc, secondpc, thirdpc, fourthpc;

   logic [pt.BTB_TOFFSET_SIZE-1:0]  f1poffset;
   logic [pt.BTB_TOFFSET_SIZE-1:0]  f0poffset;
   logic [pt.BHT_GHR_SIZE-1:0]  f1fghr;
   logic [pt.BHT_GHR_SIZE-1:0]  f0fghr;
   logic [3:0]   f1hist1;
   logic [3:0]   f0hist1;
   logic [3:0]   f1hist0;
   logic [3:0]   f0hist0;

   logic [3:0][$clog2(pt.BTB_SIZE)-1:0]           f0index, f1index, alignindex;

   logic [1:0]                                    f1ictype;
   logic [1:0]                                    f0ictype;

   logic [3:0]   f1icaf;
   logic [3:0]   f0icaf;
   logic [3:0]   f1dbecc;
   logic [3:0]   f0dbecc;
   logic [3:0]   f1pc4;
   logic [3:0]   f0pc4;

   logic [3:0]   f1ret;
   logic [3:0]   f0ret;
   logic [3:0]   f1way;
   logic [3:0]   f0way;


   logic [3:0]   f1brend;
   logic [3:0]   f0brend;

   logic [3:0]   alignbrend;
   logic [3:0]   alignpc4;

   logic [3:0]   alignret;
   logic [3:0]   alignway;
   logic [3:0]   alignhist1;

   logic [3:0]   alignhist0;
   logic [3:1]   alignfromf1;
   logic         i0_ends_f1, i1_ends_f1;
   logic         i0_br_start_error, i1_br_start_error;

   logic [pt.XLEN-1:1]  f1prett;
   logic [pt.XLEN-1:1]  f0prett;

   logic [3:0]   aligndbecc;
   logic [3:0]   alignicaf;
   logic         i0_brp_pc4, i1_brp_pc4;

   logic [pt.BTB_ADDR_HI:pt.BTB_ADDR_LO] firstpc_hash, secondpc_hash, thirdpc_hash, fourthpc_hash;

   logic f2_wr_en;
   logic f0_shift_wr_en;
   logic f1_shift_wr_en;

   logic [1:0] wrptr, wrptr_in;
   logic [1:0] rdptr, rdptr_in;
   logic [3:0] qwen;
   logic [1:0]   first_offset, second_offset;
   logic [1:0]   q3off_eff, q3off_in, q3off;
   logic [1:0]   q2off_eff, q2off_in, q2off;
   logic [1:0]   q1off_eff, q1off_in, q1off;
   logic [1:0]   q0off_eff, q0off_in, q0off;
   logic         f0_shift_2B, f0_shift_4B, f0_shift_6B;

   logic [1:0]   q0ptr;
   logic [3:0]   q0sel;

   logic [1:0]   q1ptr;
   logic [3:0]   q1sel;

   logic [3:0]   qren;

   logic         consume_fb1, consume_fb0;
   logic [1:0]   icaf_eff;


   logic [3:0]   fetch_val;

   logic         error_stall_in, error_stall;
   localparam MHI   = 32+pt.BTB_TOFFSET_SIZE+pt.BHT_GHR_SIZE;
   localparam MSIZE = 33+pt.BTB_TOFFSET_SIZE+pt.BHT_GHR_SIZE;

   logic [MHI:0] misc_data_in, misc3, misc2, misc1, misc0;
   logic [MHI:0] misc1eff, misc0eff;

   localparam FA_INDEX_SZ=$clog2(pt.BTB_SIZE);
   localparam BRDATA_SIZE=32+($clog2(pt.BTB_SIZE)*4*pt.BTB_FULLYA);
   localparam BRDATA_WIDTH = 8+($clog2(pt.BTB_SIZE)*pt.BTB_FULLYA);

   logic [BRDATA_SIZE-1:0] brdata_in, brdata3, brdata2, brdata1, brdata0;
   logic [BRDATA_SIZE-1:0] brdata1eff, brdata0eff;
   logic [BRDATA_SIZE-1:0] brdata1final, brdata0final;
   logic  i1_icaf;
   logic  i1_dbecc;
   logic [31:0] i0,i1;
   logic [pt.BTB_BTAG_SIZE-1:0] firstbrtag_hash, secondbrtag_hash, thirdbrtag_hash, fourthbrtag_hash;

   logic                        shift_f3_f2, shift_f3_f1;
   logic                        fetch_to_f3;
   logic                        f3_wr_en;
   logic                        f3_valid;

   logic                        i0_shift;

   assign f3_wr_en = fetch_to_f3;

   assign f2_wr_en = fetch_to_f2 | shift_f3_f2;

   assign f0_shift_wr_en = (fetch_to_f0 | shift_f2_f0 | shift_f1_f0 | shift_2B | shift_4B | shift_6B | shift_8B);

   assign f1_shift_wr_en = (fetch_to_f1 | shift_f3_f1 | shift_f2_f1 | f1_shift_2B | f1_shift_4B | f1_shift_6B);

   assign fetch_val[3:0] = ifu_fetch_val[3:0];

   assign error_stall_in = (error_stall | ifu_async_error_start) & ~exu_flush_final;

   rvdffie #(13) bundle1ff   (.*,
                              .din({ error_stall_in,wrptr_in[1:0],rdptr_in[1:0],q3off_in[1:0],q2off_in[1:0],q1off_in[1:0],q0off_in[1:0]}),
                              .dout({error_stall,   wrptr[1:0],   rdptr[1:0],   q3off[1:0],   q2off[1:0],   q1off[1:0],   q0off[1:0]})

                              );


   rvdff #(8) bundle2ff   (.*,
                              .clk(active_clk),
                              .din({ f3val_in[3:0],f2val_in[3:0]}),
                              .dout({f3val[3:0],   f2val[3:0]})
                              );

   rvdff #(8) bundle3ff   (.*,
                              .clk(active_clk),
                              .din({ f1val_in[3:0],f0val_in[3:0]}),
                              .dout({f1val[3:0],   f0val[3:0]})
                              );


   // new queue control logic

   assign wrptr_in[1:0] =  (({2{wrptr[1:0]==2'b00 & ifvalid}} & 2'b01) |
                            ({2{wrptr[1:0]==2'b01 & ifvalid}} & 2'b10) |
                            ({2{wrptr[1:0]==2'b10 & ifvalid}} & 2'b11) |
                            ({2{wrptr[1:0]==2'b11 & ifvalid}} & 2'b00) |
                            ({2{~ifvalid}} & wrptr[1:0])) & ~{2{exu_flush_final}};


   assign rdptr_in[1:0] =  (({2{rdptr[1:0]==2'b00 & fb_consume1}} & 2'b01) |
                            ({2{rdptr[1:0]==2'b01 & fb_consume1}} & 2'b10) |
                            ({2{rdptr[1:0]==2'b10 & fb_consume1}} & 2'b11) |
                            ({2{rdptr[1:0]==2'b11 & fb_consume1}} & 2'b00) |
                            ({2{rdptr[1:0]==2'b00 & fb_consume2}} & 2'b10) |
                            ({2{rdptr[1:0]==2'b01 & fb_consume2}} & 2'b11) |
                            ({2{rdptr[1:0]==2'b10 & fb_consume2}} & 2'b00) |
                            ({2{rdptr[1:0]==2'b11 & fb_consume2}} & 2'b01) |
                            ({2{~fb_consume1&~fb_consume2}} & rdptr[1:0])) & ~{2{exu_flush_final}};


   assign qren[3:0] = { rdptr[1:0]==2'b11,
                        rdptr[1:0]==2'b10,
                        rdptr[1:0]==2'b01,
                        rdptr[1:0]==2'b00
                        };

   assign qwen[3:0] = { wrptr[1:0]==2'b11 & ifvalid,
                        wrptr[1:0]==2'b10 & ifvalid,
                        wrptr[1:0]==2'b01 & ifvalid,
                        wrptr[1:0]==2'b00 & ifvalid
                        };


   assign first_offset[1:0]  = {f0_shift_6B|f0_shift_4B,  f0_shift_6B|f0_shift_2B };

   assign second_offset[1:0] = {f1_shift_6B|f1_shift_4B,  f1_shift_6B|f1_shift_2B };


   assign q3off_eff[1:0] = (rdptr[1:0]==2'd3) ? (q3off[1:0] + first_offset[1:0])  :
                           (rdptr[1:0]==2'd2) ? (q3off[1:0] + second_offset[1:0]) :
                                                 q3off[1:0];

   assign q3off_in[1:0] = (qwen[3]) ? {2'b0} : q3off_eff[1:0];


   assign q2off_eff[1:0] = (rdptr[1:0]==2'd2) ? (q2off[1:0] + first_offset[1:0])  :
                           (rdptr[1:0]==2'd1) ? (q2off[1:0] + second_offset[1:0]) :
                                                 q2off[1:0];

   assign q2off_in[1:0] = (qwen[2]) ? {2'b0} : q2off_eff[1:0];


   assign q1off_eff[1:0] = (rdptr[1:0]==2'd1) ? (q1off[1:0] + first_offset[1:0])  :
                           (rdptr[1:0]==2'd0) ? (q1off[1:0] + second_offset[1:0]) :
                                                 q1off[1:0];


   assign q1off_in[1:0] = (qwen[1]) ? {2'b0} : q1off_eff[1:0];



   assign q0off_eff[1:0] = (rdptr[1:0]==2'd0) ? (q0off[1:0] + first_offset[1:0])  :
                           (rdptr[1:0]==2'd3) ? (q0off[1:0] + second_offset[1:0]) :
                                                 q0off[1:0];


   assign q0off_in[1:0] = (qwen[0]) ? {2'b0} : q0off_eff[1:0];




   assign q0ptr[1:0] = (({2{rdptr[1:0]==2'b00}} & q0off[1:0]) |
                        ({2{rdptr[1:0]==2'b01}} & q1off[1:0]) |
                        ({2{rdptr[1:0]==2'b10}} & q2off[1:0]) |
                        ({2{rdptr[1:0]==2'b11}} & q3off[1:0]));

   assign q1ptr[1:0] = (({2{rdptr[1:0]==2'b00}} & q1off[1:0]) |
                        ({2{rdptr[1:0]==2'b01}} & q2off[1:0]) |
                        ({2{rdptr[1:0]==2'b10}} & q3off[1:0]) |
                        ({2{rdptr[1:0]==2'b11}} & q0off[1:0]));

   assign q0sel[3:0] = {
                         q0ptr[1:0]==2'b11,
                         q0ptr[1:0]==2'b10,
                         q0ptr[1:0]==2'b01,
                         q0ptr[1:0]==2'b00
                         };

   assign q1sel[3:0] = {
                         q1ptr[1:0]==2'b11,
                         q1ptr[1:0]==2'b10,
                         q1ptr[1:0]==2'b01,
                         q1ptr[1:0]==2'b00
                         };

   // end new queue control logic


   // misc data that is associated with each fetch buffer


   assign misc_data_in[MHI:0] = {
                                  ic_access_fault_type_f2[1:0],
                                  ifu_bp_btb_target_f2[pt.XLEN-1:1],
                                  ifu_bp_poffset_f2[pt.BTB_TOFFSET_SIZE-1:0],
                                  ifu_bp_fghr_f2[pt.BHT_GHR_SIZE-1:0]
                                  };
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
