chipsalliance/Cores-VeeR-EH2/(commit log)

2020-05-15 Added hex data for sample programs.
2021-04-20 Tighten paramter checking in swerv.config.
2021-04-26 Changes missed for Riviera pull request.
    [eh2_dec_decode_ctl.sv, eh2_lsu_bus_buffer.sv]
2026-07-20 Add Markdown-based EH2 documentation and CI flow
    Co-authored by: Grzegorz Latosinski <glatosinski@antmicro.com>
2026-09-04 Throw fatal error on failing tests by default
    [tb_top.sv]
2026-09-04 Fix mailbox write detection
    [ahb_sif.sv]
2026-09-04 Cleanup and support for misaligned memory accesses
    [tb_top.sv, test_tb_top.cpp]
2026-09-17 rtl: dma: Add XLEN support to dma_ctrl
2026-09-17 Convert missed signals to XLEN
    [eh2_veer.sv, eh2_veer_wrapper.sv]
